sofi1209/TALAVERA-v1-TestBench/hardware/README.md

# Hardware

KiCad projects for the two TALAVERA boards.

| Project | Board | Outline |
|---|---|---|
| `talavera-bench/` | Bench board — mounts on the test stand | 100 × 80 mm **placeholder** |
| `talavera-station/` | Control station board — operator position, 20 m away | 80 × 60 mm **placeholder** |
| `libraries/` | Project symbols, footprints and 3D models | — |

---

## Status: schematics drawn, values incomplete

> Both boards now carry a full schematic. **96 components across the two sheets**, zero structural
> errors. Nothing is approved and no board has been fabricated.
>
> The pyro and analog blocks are complete in **topology** but carry `TBD` values, because `R_TEST1`/`R_TEST2` (Rev A.2),
> the fuse and relay ratings need the e-match no-fire current (O-1), and the PGA gain, excitation
> and reference choice need the load cell datasheet (O-2).
>
> One block is deliberately **not drawn**: the path-2 monitor buffer (O-19). No part is chosen, so
> no circuit was invented for it.

| Board | Components | Nets | Sheet |
|---|---|---|---|
| `talavera-bench` | 54 | 47 | A2, nine labelled blocks |
| `talavera-station` | 42 | 31 | A2, six labelled blocks |

Both are **flat single sheets** with net-label connectivity rather than hierarchical sheets. At this
size that is easier to review than nine sub-sheets, and every block is boxed and titled.

### Generated, not hand-drawn

The `.kicad_sch` files are produced by `tools/gen_bench.py` and `tools/gen_station.py` on top of
`tools/ksch.py`, which reads symbol definitions straight out of the installed KiCad libraries and
flattens `extends` inheritance. Regenerate with:

```bash
cd hardware/tools && python gen_bench.py && python gen_station.py
```

`tools/validate_sch.py` checks structure independently of KiCad — paren balance, that every `lib_id`
resolves, that every instance pin exists in its symbol, duplicate references, off-sheet placement,
orphaned labels and single-use nets:

```bash
python hardware/tools/validate_sch.py hardware/talavera-bench/talavera-bench.kicad_sch hardware/talavera-station/talavera-station.kicad_sch
```

They are ordinary KiCad files and can be edited by hand afterwards; just be aware a regeneration
would overwrite manual edits.

## KiCad version

Targets **KiCad 10.0**. File format versions were read from the demo projects shipped with the installed
KiCad rather than assumed:

| File | Format version | Generator |
|---|---|---|
| `.kicad_sch` | `20250610` | `eeschema` |
| `.kicad_pcb` | `20250513` | `pcbnew` |
| `.kicad_pro` | `meta.version 3` | — |

Opening these in an older KiCad will fail or force a downgrade. If you need an older version, say so
and the projects will be regenerated.

---

## Net classes

Defined up front so that **DRC enforces pyro separation**, rather than relying on a reviewer noticing a
thin trace. Nets are assigned by name pattern, so a correctly named net inherits the right rules
automatically.

| Class | Pattern | Clearance | Track width | Why |
|---|---|---|---|---|
| `PYRO` | `PYRO_*` | 1.00 mm | 2.00 mm | Firing current, and the widest clearance on the board |
| `SAFETY` | `ARM_*`, `FIRE_*`, `ESTOP_*` | 0.50 mm | 0.50 mm | Safety signalling |
| `POWER` | `+12V*`, `+5V*` | 0.40 mm | 1.00 mm | Supply rails |
| `ANALOG` | `LC_*`, `THRUST_*` | 0.30 mm | 0.30 mm | Load cell and thrust signal |
| `Default` | everything else | 0.25 mm | 0.30 mm | — |

**Use these prefixes when naming nets at Gate 2.** A firing net not named `PYRO_*` will silently inherit
`Default` rules, which is exactly the failure this scheme exists to prevent.

---

## Voltage domains

The logger is an **ESP32-WROOM-32D at 3.3 V** (D-028). That has knock-on effects for Gate 2:

| Domain | Parts | Note |
|---|---|---|
| 12 V | Input protection, relay coils, beacon | Battery rail |
| 5 V | AD620 (path B only), 6N137 bench side on the station | **Needed after all:** the AD620's minimum total supply is 4.6 V, so it cannot run on 3.3 V (D-061). `U_5V` is depopulated while running path A. |
| 3.3 V | ESP32, converter, microSD | Keep the converter in the same domain so its digital bus needs no level translation |

Two consequences to carry into the schematic:

1. **The amplifier gain must keep its output inside the converter's input range at 3.3 V** — that is
   V<sub>DD</sub> + 0.3 V, not whatever the PGA setting might suggest. Open item 11. Note this
   constraint **disappears** if an integrated-PGA converter is chosen, since the converter then takes
   the bridge output directly.
2. **microSD is 3.3 V native**, so the level shifters a 5 V Arduino needed are gone. Do not carry over a
   5 V SD breakout module with an onboard regulator and shifters.

---

## Storage — embedded microSD socket

Decision D-037: an **on-board microSD socket**, not a breakout module. One fewer module and one fewer
set of pin headers to vibrate loose, and the lab already has both the parts and a known-good reference.

Porting the topology from IGNIS-v5 `PCB_Project_IGNIS-v5/Storage.SchDoc`. Confirmed present in that
sheet by inspection of the file:

| Element | Note |
|---|---|
| microSD socket | **THD2528-11SD-GF** (LCSC C283232) — resolved from the IGNIS v5 / MAGNIS v1 lists (D-041) |
| Pull-up resistors | Sheet is labelled "Pull UP Resistances"; 10 k values appear in the parameter set |
| Decoupling | 100 nF and 22 µF appear in the sheet's parameters |
| `SD_CS` | Chip select |
| `SD_DETECT` | **Card-present line — carry this over.** It lets the station confirm a card is seated before the test instead of discovering it afterwards. |

> The IGNIS-v5 pin assignment (`SD_MOSI` IO11, `SD_MISO` IO13, `SD_SCK` IO12, `SD_CS` IO42,
> `SD_DETECT` IO41) is for an **ESP32-S3**. TALAVERA uses the original ESP32-WROOM-32D, which numbers
> its pins differently — reuse the circuit, not the pin numbers. See `firmware/README.md` for the
> TALAVERA pin map.

---

## ADC — settled: ADS1220IPWR

**`ADS1220IPWR`** (D-046): 24-bit, **SPI**, 2 kSPS, integrated PGA ×1–128, TSSOP-16, stocked at both
UNIT and LCSC (C48263). It replaces the ADS1115 and removes the I²C bus that both Wirikuta and IGNIS-v5
had trouble with. Reasoning and the rejected candidates are in
[../docs/ADC-TRADE-STUDY.md](../docs/ADC-TRADE-STUDY.md).

The AD620 is **not populated**. Its DIP-8 socket and a four-link network are laid out so either front
end can be fitted: links `R_BYP1`+`R_BYP2` fitted gives the PGA-only chain (default), while
`R_BYP3`+`R_BYP4` plus the chip gives the two-stage chain. Never fit all four — that shorts the
amplifier output to the bridge.

---

## Design rules that layout must satisfy (Gate 4)

1. Keep-out between the logger zone and the entire firing chain.
2. Connectors on the board edge.
3. Pin 1 marked on every connector, on silkscreen, readable after assembly.
4. Keyed, strain-relieved connectors on every external interface.
5. Analog return separated from high-current return; join at a single defined point.
6. Test points on every rail and every safety signal, probe-accessible with the board mounted.
7. Pyro traces routed away from the analog front end, never parallel to it.

---

## Running checks

KiCad is not run by the design assistant. To produce the reports for Gate 5, run these and paste back
the output:

```bash
kicad-cli sch erc --output erc-bench.rpt hardware/talavera-bench/talavera-bench.kicad_sch
```

```bash
kicad-cli pcb drc --output drc-bench.rpt hardware/talavera-bench/talavera-bench.kicad_pcb
```

Both write a plain-text report to the named file. The same two commands apply to `talavera-station`.
