sofi1209/TALAVERA-v1-TestBench/docs/external-audits/AUDIT-B-chatgpt-2026-11-09.md

# TALAVERA v1 schematic audit

9 November 2026 · Bench and operator station · Revision A · GitHub main at `43e980364137857c72099dcaf6f4be3cf3cbf186`

**Disposition — hold schematic release.** The current design has faults that prevent the bench from powering normally, prevent the station from obtaining its documented supply through the harness, and leave the firing output without a return. The interlock and continuity defects would remain after those connectivity issues were addressed. The hardware-only control architecture is worth keeping. The primary measurement path can be simplified and validated separately from the safety and telemetry circuits.

## What was checked

- Reviewed both uploaded schematic PDFs, their KiCad 10.0.5 netlist exports and ERC reports, and the handoff. Cloned GitHub and inspected both committed KiCad schematics, their generators, requirements, safety decisions, fabrication lists, firmware and bring-up plan. The committed PCB files contain outlines without footprints or routing.
- Re-extracted pin connectivity from the committed schematics with the repository extractor pointed at the symbols embedded in each sheet. All non-power-symbol pin groups matched the attachments, including unnamed groups and no-connect pins. Bench **59 components, 76 groups**. Station **41 components, 48 groups**. Re-ran the project validator with the embedded symbols and reproduced **0 errors / 1 warning** on bench and **0 / 0** on station. The stock tool has a Windows symbol path and skips unresolved symbols, so a bare invocation elsewhere can give misleading results.
- The supplied KiCad ERC reports show **1 error / 2 warnings** on bench and **0 / 0** on station. Local KiCad 9.0.2 could not open the committed files, so I could not independently rerun native KiCad 10 ERC. The reported bench findings agree with the connectivity. I enumerated all 16 static ARM/FIRE/E-STOP/plug combinations and several single faults in a software model of ideal relay contacts. That test assumes healthy supplies, omits transients and is independent of the diode error. No board, firmware build, hardware waveform, physical harness or live test was available.
- **Verified** identifies a source, schematic, netlist or model result. **Conditional** identifies a consequence dependent on a stated assumption, physical test, part selection or revised circuit. Component values without verified part-level evidence remain unqualified.

## Findings in priority order

| ID | Severity | Location | Evidence | Why it matters | Recommended fix or closure | Status |
|---|---|---|---|---|---|---|
| B01 | Blocker | Bench `D_RP1`, `gen_bench.py:26–43` | SS24 pin 1 cathode is on `+12V_FUSED`, and pin 2 anode is on `+12V_PROT`. | Normal battery polarity reverse-biases the series device. The logger and K4 supply are downstream. | Correct the polarity in the generator. Verify real package marking and pad mapping. Re-evaluate the selected part's forward drop, current, heating and fault withstand with the approved power architecture. | Verified polarity. Part suitability open. |
| B02 | Blocker | Station `J_12V1`, both `J_UMB1`, `gen_station.py:23–46` | The matched 12-pin umbilical contains no supply conductor. `+12V_STN` is exposed at `J_12V1`, and `PWR_FLAG` asserts power to ERC. `VBAT_SENSE` comes from a divider. | The station cannot power its ARM/FIRE controls, lamps or receiver through the documented cable. USB only powers the isolated side. A hidden extra feed undermines assembly and field diagnosis. | Decide and document one power architecture. Release a keyed connector and harness drawing with supply, returns, branch protection and shield termination. Resolve the disagreement before pin assignment. | Verified absent feed. Supply architecture open. |
| B03 | Blocker | Bench `P1.2`, `K3.12`, `U_CONT1.2`, `gen_bench.py:106–139` | `PYRO_MATCH_N` has exactly those three pins. The optocoupler transistor emitter's ground is across an isolation boundary. K3 NC only shorts the two output terminals together. | There is no intentional DC return from the load to the source even when `PYRO_MATCH_P` is energized. A grounded scope, harness fault or later rework can change the as-drawn circuit. | Review the complete output and return architecture as one safety circuit with the review owner. Validate differential voltage and return paths on a floating inert fixture. Carry B04–B06 into the same review. | Verified open return. |
| B04 | Blocker | Both boards, `R_CONT1`, `U_CONT1`, `D_CONT1`, K3 | Bench part is **PC817**, while the **6N137** belongs to station telemetry. The PC817 input and resistor are across the load. No independent stimulus exists. K3 shorts the input terminals when disarmed. A station sense-wire short to GND lights `CONTINUITY OK`. | The schematic cannot distinguish a connected load from an open load before arming. The handoff's assertion of permanent current through the load is unsupported. Simply providing a return would still leave a voltage detector that could light with the load open when the output is energized. | Define a separately reviewable, hardware-only pre-arm continuity function with explicit open, short and broken-sense behavior. Close it against the exact initiator specification and a fault analysis. Retire the current `CONTINUITY OK` claim. | Verified topology and false-good wire fault. Initiator limits and future circuit open. |
| B05 | Blocker | K4, `ESTOP_LOOP`, K3, `J_ESTOP1` | E-STOP interrupts K4's coil return only. K1/K3 remain commanded by ARM, and K2 remains commanded if FIRE is held. Reset with both held restores source to `PYRO_MATCH_P` when the plug is present. An `ESTOP_LOOP` short to GND or welded K4 NO defeats the stop in the ideal contact model. | The stop removes master feed in the nominal case while leaving the shunt released if ARM remains active. It cannot ensure no automatic restart. A single fault can bypass the master interrupt once the rest of the circuit is closed. Relay release under the flyback clamp has no verified timing. | Specify what E-STOP must de-energize, require deliberate hardware reset and re-arm, and independently verify energy removal, shunt behavior, contact faults and stop latency with an inert fixture. Resolve the single-point stop dependency before release. | Verified connectivity and modeled behavior. Timing and revised safety architecture open. |
| B06 | Blocker | Umbilical pins 1–3, K1/K2/K3, panel controls | One short between `ARM_LINE` and `FIRE_LINE` bypasses the FIRE switch when armed. A stuck FIRE button creates a similar condition on ARM. K1 and K3 follow the same wire without contact feedback. | The two deliberate actions are independent in the schematic's healthy switch sequence only. With source power and the plug present, one common harness fault can assert the output command. The present open return masks delivery of load current. | Define the harness and interlock fault model, including adjacent-conductor shorts, open returns, partial connection and held controls. Verify it with the protected output disabled or with an authorized inert fixture. Keep ARM, FIRE and E-STOP hardware-only. | Verified fault path. Physical fault behavior and closure open. |
| B07 | Blocker | O-1/O-3/O-17, F1/F2, K1–K4, J_ARM1/P1, `SAFETY.md` | The exact initiator limits, installed contact and terminal ratings, fuse selections, wiring limits and pad mappings remain open. The README contains an older current-budget example for a different cable architecture. | There is no basis to qualify protection, energy limits, contact life or fuse coordination. A shunt fault, supply dip or logger short can interact with shared upstream protection and grounds. | Record exact manufacturer part numbers and review evidence. Reconcile the fault-current and protection review with the actual harness and hardware. Demonstrate that a logger fault cannot defeat the safety functions or invalidate the claimed data retention. | Verified omissions. Margins and outcomes open. |
| B08 | Blocker | Bench `U_3V3`, station `U_5VB1`/`U_3V3B1`, DNP `U_5V1` | Bench input has C2, 22 µF. `+3V3_LOGGER` has nominal 20 µF plus four 100 nF parts spread across loads, with no specified local regulator compensation capacitor/ESR. Station has zero caps on all three bench-referenced rails. `+5V_AMP` has no output cap. The reference AMS1117 data sheet uses output capacitance as compensation. | Startup, ripple and load-transient response are unqualified. The bench 12 V-to-3.3 V drop can exceed the thermal budget. Station cascade has limited dropout margin. A 12 V SLA system needs margin to the regulator's maximum input under charging and transients. | Select exact regulators. For the bench, use a serviceable buck stage for digital power and a separately filtered analog supply if measurements require it. Budget input/output effective capacitance, ESR, quiescent current, load steps, temperature, charging voltage and startup. If keeping the station cascade, prove regulation at minimum rail and worst cable drop. | Verified cap topology. Thermal calculation below uses assumptions. See [AMS1117 data sheet](https://www.datasheets.com/advanced-monolithic-systems/ams1117/datasheet.pdf). |
| M01 | Major | Bench MCU1 / DevKitC headers, `ESP_EN`, `+3V3_LOGGER` | All intended active GPIOs match the bare-module pin functions in the export, but the real DevKitC header numbers and power pins differ. The bare-module GND pad set includes pad 39. Espressif specifies mutually exclusive USB, 5 V header and 3.3 V header power inputs. | Mapping by matching numbers can miswire a replacement module. Programming over USB while the carrier drives 3.3 V can tie supplies together. An unpowered peripheral can be backfed through I/O. | Draw the two actual headers, verify an exact WROOM-based module variant and orientation, and define a mutually exclusive service/programming power mode. Add an accessible rail disconnect and review the on-module EN network. | Verified symbol mismatch. Backfeed behavior needs hardware testing. [Espressif DevKitC guide](https://docs.espressif.com/projects/esp-dev-kits/en/latest/esp32/esp32-devkitc/user_guide.html). |
| M02 | Major | Station `U_ISO1/R_ISO1`, both `U_485`, `logger.ino` | The enabled 6N137 inverts. SP3485 RO sources current through 220 Ω into its LED, but RO's guaranteed high level is specified at 1.5 mA sourcing. The cited 6N137 threshold can be 5 mA. There is no dedicated bypass at the opto, no explicit fail-safe bias for the terminated idle pair, and no bench DE reset bias. Firmware has no RS-485 TX/DE implementation. | Ordinary high UART idle becomes low at CH340C RX unless polarity is corrected. The handoff's LED-current estimate assumes an ideal 3.3 V source. Reset and missing-transmitter states can corrupt reception. Optional reverse path is DNP and fitting it alone cannot enable a driver strapped off. | Use a buffered or inherently compatible, receive-only isolated interface with correct end-to-end polarity, local bypass and a defined idle/reset state. Verify with a known pattern at both UARTs, absent cable and independent USB/bench power sequences. Remove the optional reverse path from the default build documentation. | Verified topology and firmware omission. Margin and idle behavior conditional. [SP3485](https://www.maxlinear.com/ds/sp3485.pdf), [Vishay 6N137](https://www.vishay.com/docs/84732/6n137.pdf), [Lite-On 6N137](https://www.mouser.com/datasheet/2/813/6N137_Series-1516684.pdf). |
| M03 | Major | J_UMB1 pins 10–12, J_DAQ1.3, USB and exposed I/O | Shield-designated pin 12 is on GND at both boards. Station `GND` and `GNDREF` are separate in the netlist. J_DAQ exports bench GND. The USB data TVS pair is the only explicit external-line clamp protection shown. | Harness and enclosure bonds can defeat a single-point shield plan. A grounded DAQ used alongside the same laptop can bridge the isolation barrier externally. Cable faults or ESD can affect controls and telemetry. | Publish a complete shield, chassis and return diagram with external equipment connected. Keep the USB ground separation through layout and verify it in the installed setup. Choose protection for exposed lines with a failure-mode review, especially devices that could short the E-STOP return. | Verified connectivity. Installed grounding and surge performance open. |
| M04 | Major | Station `LS1/Q_BUZZ1` and hardware indications | Huaneng MLT-8530 is a low-voltage passive transducer characterized with an AC square wave. It is switched from nominal 12 V DC. Station ARM indicates the command line, bench ARM indicates `ARM_BUS`, and FIRE indicates `PYRO_FIRE_OUT` upstream of the plug. | Audible warning can fail or overheat. The lamps cannot establish plug insertion, a released shunt, load current, or safe state when dark. | Use a replaceable panel sounder rated for the actual DC rail. Label command and actual state separately, and verify any indication claimed as an interlock using actual hardware feedback. | Verified wiring and buzzer mismatch. [Huaneng data sheet](https://datasheet.lcsc.com/lcsc/1811182003_Jiangsu-Huaneng-Elec-MLT-8530_C94599.pdf). |
| M05 | Major | Bench U_ADC1, J_LC1, R_EXC_P1/N1, ADC inputs | Default path selects AIN0/AIN1 and physically references REFP0/REFN0 to board-side bridge excitation. Bridge, ADC and digital loads share 3.3 V. No analog input filter or fault protection is drawn. | Ratiometric conversion can reject slow excitation changes common to signal and reference. It cannot cancel lead drops outside the reference sense points, supply/return disturbances, unequal filtering or ADC saturation. | Freeze O-2. Validate the sensor's wiring, bridge resistance, mV/V, excitation, zero offset, overload and required bandwidth. Check PGA common mode and full-scale analytically. Add separate close AVDD/DVDD bypass, balanced input filtering and connector-side protection as required. Verify zero, span and noise with a bridge simulator and actual sensor. | Verified wiring, conditionally sound topology. [TI ADS1220 data sheet](https://www.ti.com/lit/ds/symlink/ads1220.pdf). |
| M06 | Major | Bench DNP `U_AMP1`, `AMP_REF`, `R_BYP1–4` | `AMP_REF` connects only to AD620 REF and the DNP ADC negative link. It has no low-impedance bias source. The optional 5 V regulator has no output cap. All four links fitted tie the amplifier outputs/reference network onto bridge signal nodes. | Path B cannot be validated from the shown wiring. A nominal 5 V supply alone does not establish input common mode, output swing or compatibility with the 3.3 V ADC. The population options add avoidable assembly errors. | For a maintainable Rev A, keep the direct ADS1220 path and remove the unqualified alternative from the standard assembly. If needed, qualify Path B separately with reference drive, headroom and mutually exclusive population. | Verified absent bias and caps. Headroom conditional. [Analog Devices AD620](https://www.analog.com/en/products/AD620.html). |
| M07 | Major | `logger.ino:96–112, 139–161, 219–255`, CARD1 | Register placeholders select gain 1 and 20 SPS normal continuous mode. The trade study targets at least 1 kSPS. Firmware prints placeholder scaled counts as `thrust_N`, uses synchronous CSV writes and flush, has no sequence counter and relies on polling DRDY. SD init failure leaves the logger inactive until reset. ADC CS has no hardware pull-up. SD connector detect pad numbering disagrees with the schematic note and BOM. | The logger can miss the transient or drop conversions silently. A card or power problem can appear as a recorded or calibrated test when it was neither. | Establish raw-only behavior until calibration. Log config, timestamps, sample sequence and dropped counts. Verify sustained capture through SD stalls, interrupted power and restart. Define a distinct fault indicator, hardware CS defaults and local card decoupling. Bench-check the actual connector detect switch and retention. | Verified code and pin discrepancy. Detect mechanism, losses and throughput open. [TI ADS1220](https://www.ti.com/lit/ds/symlink/ads1220.pdf), [LCSC socket listing](https://www.lcsc.com/product-detail/C283232.html). |
| M08 | Major | Both `THRUST_DIFF_*` lines, J_DAQ1, O-19 | Bench ends at J_UMB pins 8/9. Station carries the same pins to J_DAQ. The bench note explicitly omits the buffer. | The advertised analog backup cannot produce a signal. The circuit can be present at both connectors and still have no source. | Either implement and independently validate the required measurement path, or defer it explicitly in the requirements and mark the pins reserved. Record the loss of redundancy in Rev A. | Verified. |
| M09 | Major | `R_V1/R_V2`, `VBAT_SENSE`, J_VM1 | Divider reads `+12V_PROT`, after D_RP. Ratio is 10/57. No meter model or independent meter supply is drawn. | A generic voltmeter cannot be assumed to scale or power correctly. Cable return drop and input loading alter the reading. | Select a high-impedance readout with a verified scale and supply. Decide whether the requirement refers to battery terminal voltage or protected-rail voltage and label it accordingly. | Verified ratio and missing meter spec. Measurement error conditional. |
| M10 | Major | Both sheets, fabrication CSVs, generator and release checks | No test-point symbols are present in the exports. BOM still lists the deleted continuity switch and obsolete umbilical pyro pair. The relays have generic IEC pin identifiers, Q_BUZZ uses letter pins, and USB/microSD require exact physical pad maps. Generators hard-code local Windows paths. | A board can pass ERC and still be assembled from a stale BOM or built with swapped contacts. Fault isolation and module replacement become slow. | Make generator output paths portable. Generate a revision-locked BOM and harness from the reviewed schematic, fail checks on missing libraries, and validate the symbol-to-footprint map against each actual part. Add accessible, labeled service points and removable branch links. | Verified source and BOM. Physical pad maps unverified. |
| M11 | Major | `SAFETY.md §7`, README, D-007/D-011 | Repository estimates 15–17 m actual separation with its 20 m harness, below its own cited minimum. NAR S&T manual §8.3.5 ties open-ground static testing to launch-code separation and allows reduction when protected by a substantial barrier at the supervisor's judgment. | An internal deviation entry does not qualify separation for the site. Harness length and cable loss affect station operation and the fault review. | Resolve actual site, motor class, barrier, governing requirements and usable separation with the review owner before finalizing harness requirements. | Verified repo inconsistency and NAR language. Applicability in Mexico requires site-specific determination. [NAR S&T testing manual](https://thisistheoldsite.nar.org/wp-content/uploads/2014/08/ST-MotorTestingManual.pdf). |
| N01 | Minor | Station USB data and CC pins | Independent 5.1 kΩ CC pull-downs and paired D+/D− orientation pins are coherent. WCH's reference application should govern the final data-series arrangement. USB-C symbol-to-part map and local enclosure shielding are open. | A connection that enumerates in one orientation or one host can still be mechanically or electrically fragile. | Confirm the exact connector drawing, both plug orientations, enumeration with realistic cables, and a footprint that can be replaced without stripping pads. | Verified netlist. Hardware unverified. [WCH CH340 data sheet](https://datasheet.lcsc.com/lcsc/2304140030_WCH-Jiangsu-Qin-Heng-CH340C_C84681.pdf). |

## Polarity and contact sweep

- **Series Schottky** — D_RP1 is reversed. K is on `+12V_FUSED` and A on `+12V_PROT`.
- **Bench flybacks** — D_K1 and D_K3 are K to `ARM_LINE`, A to GND. D_K2 is K to `FIRE_LINE`, A to GND. D_K4 is K to `+12V_PROT`, A to `ESTOP_LOOP`. Each diode is reverse-biased while its coil is normally energized. Verify physical polarity and contact-release timing with the suppression circuit fitted.
- **Station flyback** — D_BUZZ1 is K to `+12V_STN`, A to `BUZZ_DRV`. This orientation is consistent with a low-side inductive load. The specified sounder and drive are separately incorrect. The Q_BUZZ divider computes 4.86 V at a 12 V ARM line versus the onsemi device's ±20 V absolute gate rating. Match symbol G/S/D to physical pads 1/2/3. [onsemi NTS4001N](https://www.onsemi.com/download/data-sheet/pdf/nts4001n-d.pdf).
- **LEDs** — Bench D_ARM1, D_FIRE1, D_PWR1 and D_LOG1 have cathodes on GND and resistor-fed anodes. Station D_ARMED1 and D_PWR1 follow the same pattern. D_CONT1 has its anode fed through a resistor from `+12V_STN` and cathode on the PC817 collector signal. The lamp polarity is correct for active-low signaling. Its meaning is wrong because the input circuit does not measure continuity.
- **Optocouplers** — PC817 uses pins 1/2 for LED A/K, 3 for emitter to GND and 4 for the sense collector. Both 6N137 symbols use LED A/K on 2/3 and output-side GND/OUT/EN/VCC on 5/6/7/8. Their LEDs have the intended polarity. Active inversion and drive current remain issues. [Vishay 6N137](https://www.vishay.com/docs/84732/6n137.pdf).
- **TVS and capacitors** — D_ESD1/2 are bidirectional ESD9B5.0ST5G between USB D+/D− and GNDREF, so there is no diode orientation error. The two SOD-923 packages are difficult to replace by hand. All 11 capacitor symbols across both boards are generic, unpolarized `Device:C`. Bench C1/C2 each show pin 1 on the positive rail and pin 2 on ground. Any polarized implementation needs an exact MPN, polarized symbol and verified footprint. [onsemi ESD9B](https://www.onsemi.com/download/data-sheet/pdf/esd9b-d.pdf).
- **Relay rest states** — K1, K2 and K4 use COM 11 and NO 14. K3 uses COM 11 and NC 12. Ideal de-energized contacts open the three series paths and close the shunt. This verifies the drawing's contact selection. Exact Songle physical pin mapping, bounce, pickup/dropout, welds and recovery remain open. [Songle SRD listing](https://www.lcsc.com/product-detail/Relays_SRD-12VDC-SL-C_C30431.html).

## Power and measurement checks

**Rail chain.** On the bench, `+12V_RAW → F1 → +12V_FUSED → D_RP1 → +12V_PROT`. K4 switches `+12V_MASTER`, while F2 separately feeds `+12V_LOGGER` upstream of K4. `+3V3_LOGGER` runs the DevKitC, ADS1220, SD, SP3485 and bridge. The DNP `+5V_AMP` serves only the DNP amplifier. On the station, `J_12V1 → +12V_STN → U_5VB1 → +5V_BENCH → U_3V3B1 → +3V3_BENCH`. The fitted station optocoupler output and USB-UART are fed by `+5V_USB`, independently of the station's bench-side supply. Add the bench logger-rail PWR_FLAG only after documenting the actual source through F2. The station PWR_FLAG cannot supply an omitted harness feed.

**Budget.** For the handoff's assumed 12.0 V at regulator input and 150 mA, bench regulator dissipation is about `(12.0 − 3.3) × 0.15 = 1.305 W`, excluding regulator ground current. At assumed 55 °C ambient and 60 °C/W, the estimate is 133 °C. Actual copper, enclosure and current are unknown. A 12→5→3.3 linear cascade at the same current splits the same heat into about 1.05 W and 0.255 W. It reduces the second stage's heating but leaves the first stage dissipating about 1 W. The cited AMS1117 test range for the 3.3 V fixed part begins at 4.75 V. A nominal 5 V upstream rail therefore leaves about 0.25 V to that point before tolerance, ripple and wiring loss. Budget average and peak currents separately. Include DevKitC startup, SD writes, bus loading, bridge current `V_EXC/R_bridge`, indicators, relay coil pickup, cable drops and all normal power combinations. At nominal coil voltage the 400 Ω Songle coil is about 30 mA, or 120 mA for four coils supplied across the two domains, excluding all other loads. These values do not constitute a complete supply or fault budget. [AMS1117 data sheet](https://www.datasheets.com/advanced-monolithic-systems/ams1117/datasheet.pdf), [Songle SRD listing](https://www.lcsc.com/product-detail/Relays_SRD-12VDC-SL-C_C30431.html).

**Battery readback.** With an unloaded divider and 12 V at `+12V_PROT`, expected `VBAT_SENSE` is 2.105 V. The divider output impedance is approximately 8.25 kΩ. Include meter input loading, offset and ground difference in the calibration. A threshold specified at the battery terminals cannot be transferred uncorrected to a post-diode measurement.

**ADC.** With `AVDD = 3.3 V` and `AVSS = 0 V`, the enabled PGA's common mode must satisfy both `VCM ≥ max(0.825 V, 0.2 V + G·|VIN|max/2)` and `VCM ≤ 3.1 V − G·|VIN|max/2`, in addition to the differential full-scale limit set by reference voltage and gain. A balanced bridge near mid-excitation is plausible. The actual load cell can only be qualified with its offset, span, excitation and overload data. The proposed external reference is physically connected to board-side excitation, so cable drops to a four-wire bridge are outside the sense points. The placeholder 20 SPS yields a 50 ms sample interval, longer than the repository's assumed 10–30 ms rise. [TI ADS1220 data sheet](https://www.ti.com/lit/ds/symlink/ads1220.pdf).

## Changes that make this bench easier to repair

1. **Partition it by fault domain.** Give the mechanical control/output circuit, logger/analog rail and station telemetry independently identifiable connectors, protection and accessible disconnects. Preserve the logger's upstream supply intent. A dead logger, SD card, USB interface or optional monitor should be diagnosable without disturbing the hardware interlocks.
2. **Make state and power visible.** Provide labeled probe points with adjacent return points for raw/fused/protected power, master, logger and analog rails, station supply, isolated USB supply, control lines, and the two ADC inputs and reference pins. Keep sensitive output test access recessed or shrouded. Put meter-friendly pin numbers and polarity on both mating drawings and the silkscreen. Document expected voltage and continuity for each troubleshooting state.
3. **Prioritize easy replacement.** Use keyed, locking, mechanically supported harness connectors, replaceable fuse holders, and clearance to extract the DevKitC and service the SD card without removing the board. Use larger hand-rework packages where space permits, especially at external connectors. Prefer a simple authorized population drawing over multiple overlapping DNP options. Validate connector, relay, fuse, USB, MOSFET and SD footprints with actual parts before layout release.
4. **Give each test a pass condition.** First re-export with the same KiCad version, require zero native ERC errors, disposition each warning and compare exports with committed sources. Add assertions for diode polarity, both endpoints of each intended conductor, rail source reachability, safety contact state and isolation boundaries. Then, under the project's written authorization, use a current-limited bench supply and inert fixtures for power sequencing, control-fault behavior, capture throughput, and full-harness USB/DAQ isolation. Measure rails and stop latency. Verify saved files after brownouts and abrupt interruption, and run a calibrated bridge-input test before relying on thrust data.

**Safety finding.** The schematic gives the MCU no direct path to drive a relay coil or the firing output. Its RS-485 signals share the same field harness and the logger shares supply and ground infrastructure. A proof that a single logger fault cannot energize the output requires analysis of the installed wiring, rail faults, clamp faults, contact faults and cross-shorts. The contact model and ERC do not establish that property. This audit gives no hardware or live-test sign-off.

## Project references

- [Pinned GitHub revision](https://github.com/sofi1209/TALAVERA-v1-TestBench/tree/43e980364137857c72099dcaf6f4be3cf3cbf186)
- [Bench generator](https://github.com/sofi1209/TALAVERA-v1-TestBench/blob/43e980364137857c72099dcaf6f4be3cf3cbf186/hardware/tools/gen_bench.py) · [Station generator](https://github.com/sofi1209/TALAVERA-v1-TestBench/blob/43e980364137857c72099dcaf6f4be3cf3cbf186/hardware/tools/gen_station.py)
- [Requirements](https://github.com/sofi1209/TALAVERA-v1-TestBench/blob/43e980364137857c72099dcaf6f4be3cf3cbf186/docs/REQUIREMENTS.md) · [Safety](https://github.com/sofi1209/TALAVERA-v1-TestBench/blob/43e980364137857c72099dcaf6f4be3cf3cbf186/docs/SAFETY.md) · [Bring-up plan](https://github.com/sofi1209/TALAVERA-v1-TestBench/blob/43e980364137857c72099dcaf6f4be3cf3cbf186/test/BRINGUP-PLAN.md)
- [Logger source](https://github.com/sofi1209/TALAVERA-v1-TestBench/blob/43e980364137857c72099dcaf6f4be3cf3cbf186/firmware/logger/src/logger.ino)
