sofi1209/TALAVERA-v1-TestBench/fabrication/PARTS-LIST.md

# TALAVERA v1 — Preliminary parts list

> ### PRELIMINARY — not a BOM
>
> **No schematic exists.** Gate 2 has not started, so there is no netlist to reconcile against.
> Designators are placeholders, quantities are estimates, and rows marked `[CANDIDATE]` carry
> **unverified** part numbers. The IGNIS v5 and MAGNIS v1 lists state that their designators and
> quantities match a netlist; **this list cannot make that claim yet.**
>
> Do not order from this document. It exists so lab stock can be checked early.

> ### Assembly constraint (D-049)
>
> The board goes to **JLCPCB assembled**, so every *populated* part must be **LCSC-stocked**.
> This is what ruled out a populated AD620: the SOIC `AD620ARZ` is listed under LCSC
> “Pre-ordered Products”, which JLCPCB very likely cannot place. Panel controls, the DevKitC
> and the AD620 bypass option are hand-fitted and exempt.

Formatted to match `IGNIS_V5_Parts_List_rev3.xlsx` and `MAGNIS_v1_Parts_List.xlsx`.
LCSC codes are reused from those lists where the part is the same.

Spreadsheet versions: [`TALAVERA_v1_Parts_List_bench.csv`](TALAVERA_v1_Parts_List_bench.csv) · [`TALAVERA_v1_Parts_List_station.csv`](TALAVERA_v1_Parts_List_station.csv) — open directly in Excel.

**Status values:** `In lab` = confirmed present in the IGNIS v5 / MAGNIS v1 lists · `Pending decision` = awaiting a gate decision · `TBD` = not yet specified · `Candidate` = proposed, unverified

| | Lines |
|---|---|
| Confirmed in lab | **30** |
| Still TBD or pending | **23** |

---

## Bench board

### LOGGER

| Status | Component name | ID # (part number) | Designator | Amount | LCSC | UNIT Electronics | Mouser MX | DigiKey MX | Notes |
|---|---|---|---|---|---|---|---|---|---|
| In lab | Dev board ESP32-DevKitC V4 (WROOM-32D, PCB antenna) | ESP32-DevKitC-32D | MCU1 | 1 | -- | UNIT | Mouser | DigiKey | Socketed, as on MAGNIS v1. Radios stopped in firmware (D-029). Choose the 32D option at UNIT. |
| In lab | Female header 1x19, 2.54 mm | PPTC191LFBN-RC | - (MCU1) | 2 | -- | UNIT | Mouser | DigiKey | Sockets for the DevKit. Cut from a 1x40 strip. Same approach as MAGNIS v1. |

### STORAGE

| Status | Component name | ID # (part number) | Designator | Amount | LCSC | UNIT Electronics | Mouser MX | DigiKey MX | Notes |
|---|---|---|---|---|---|---|---|---|---|
| In lab | MicroSD socket push-push | THD2528-11SD-GF | CARD1 | 1 | C283232 | UNIT | Mouser | DigiKey | Pin 9 CD -> SD_DETECT with a 10 k pull-UP (as IGNIS v5 R28). Locating pegs drilled 1.3 mm (MAGNIS v1). Shell pads MP1-4 to GND. |

### ANALOG FRONT END  (D-046)

| Status | Component name | ID # (part number) | Designator | Amount | LCSC | UNIT Electronics | Mouser MX | DigiKey MX | Notes |
|---|---|---|---|---|---|---|---|---|---|
| New (approved) | 24-bit ADC, SPI, 2 kSPS, integrated PGA x1-128, TSSOP-16 | ADS1220IPWR | U_ADC | 1 | C48263 | UNIT | Mouser | DigiKey | SELECTED. Replaces the ADS1115 and its I2C bus. Stocked at BOTH UNIT and LCSC (C48263, ~15.9k, ~$1.71 @100) - stock checked 6 Nov 2026, re-verify before ordering. Internal PGA is the PRIMARY front end. Verify input common-mode range with PGA enabled at 3.3 V against the load cell (open item 4). |
| Optional / socketed | Instrumentation amplifier, DIP-8 (optional) | AD620AN | U_AMP | 0 (socket fitted) | -- | UNIT | Mouser | DigiKey | DIP-8 in a SOCKET, not populated by default (D-054). UNIT stocks the through-hole part at ~111 MXN. A socket makes the A/B comparison a chip pull, not a rework. Left out by default: at ~$6-8 it is the most expensive part on the board and the ADS1220 PGA makes it redundant. |
| New (approved) | IC socket DIP-8 | Generic DIP-8 socket | XU_AMP | 1 | -- | UNIT | Mouser | DigiKey | Always fitted, so the AD620 can be added or removed without soldering. |
| New (approved) | Resistor 0 ohm 0805 - AD620 bypass links | Generic 0 R jumper | R_BYP1, R_BYP2 | 2 | -- | UNIT | Mouser | DigiKey | Fitted = PGA-only chain (default). Removed + AD620 in its socket = two-stage chain. Lets both be measured on identical hardware in bring-up Stage 4. |
| TBD | Load cell excitation reference | TBD | U_REF | 1 | -- | -- | -- | -- | Cannot be specified until the load cell datasheet is available (open item 4). Check whether the excitation can serve as the ADS1220 external reference for a ratiometric measurement, which would cancel excitation drift. |

### SAFETY CHAIN  (hardware only - no MCU)

| Status | Component name | ID # (part number) | Designator | Amount | LCSC | UNIT Electronics | Mouser MX | DigiKey MX | Notes |
|---|---|---|---|---|---|---|---|---|---|
| New (approved) | Relay SPDT, 12 V coil, 10 A contacts, through-hole | SRD-12VDC-SL-C | K1, K2, K3, K4 | 4 | C30431 | -- | Mouser | DigiKey | ONE part for all four positions (D-055). K1/K2/K4 wired NO; K3 uses BOTH contacts of its pole - NC is the shunt, NO the low-side return (D-065) - and its coil follows the FIRE command, not ARM (Batch 2, pending sign-off). K1's NC is the continuity TEST source. ~$0.23, ~131,800 in LCSC stock. The datasheet in hand is Sanyou-branded SRD V3.2 while the part is listed as Songle - provenance OPEN. Per that datasheet: 10 A NO / 6 A NC at 28 VDC, pick-up <= 9 V, release guaranteed only <= 0.6 V. Break-before-make NOT stated (O-3): measure on real units. CONTACT MARGIN still blocked on O-1. |
| TBD | Arming plug / removable shorting link | TBD | J_ARM | 1 | -- | -- | -- | -- | Withdrawn by hand at the bench, inserted last. Must be keyed and obviously absent at a glance. |
| In lab | Switching diode - relay coil flyback | 1N4148W | D_K1..D_K4 | 4 | C81598 | UNIT | Mouser | DigiKey | One per relay coil. D_K2 and D_K3 sit across the FLOATING FIRE-loop coils (cathode on A1). |
| Pending decision | Switching diode - K3 coil OR and TEST blocking | 1N4148W | D_K3F, D_K3T, D_CBLK | 3 | C81598 | UNIT | Mouser | DigiKey | Batch 2, pending sign-off. D_K3F/D_K3T OR the FIRE and TEST commands into the K3 coil (~30 mA); D_CBLK keeps the 12 V on MATCH_P during FIRE off the opto LED. 1N4148W ratings to confirm against its datasheet (not in the repo). |

### PYRO INTERFACE  (one channel - D-015)

| Status | Component name | ID # (part number) | Designator | Amount | LCSC | UNIT Electronics | Mouser MX | DigiKey MX | Notes |
|---|---|---|---|---|---|---|---|---|---|
| In lab | Optocoupler SMD-4, CTR 100-600 % | TLP521GB-S (UMW) | U_CONT | 1 | C364143 | UNIT | Mouser | DigiKey | Continuity TEST current detector (Batch 2): its LED is IN SERIES with the test current and its transistor SOURCES the active-high sense line. The schematic value reads PC817 - reconcile with this line (P-22). CTR at the very low test current O-1 will allow is UNVERIFIED and may force a different detector. |
| In lab | Screw terminal 6-pin 5.08 mm | 1729160 | P1 | 1 | C457192 | -- | Mouser | DigiKey | E-match pair plus umbilical pyro pair. Not at UNIT (KF301 is 5.0 mm pitch). |
| Candidate | N-MOSFET 60 V / 5 A (SOT-223) | NCE6005AR | Q_FIRE | 1 | C189606 | UNIT | Mouser | DigiKey | ONLY if a solid-state firing element is chosen downstream of the relays. Relays remain the primary interrupt. |
| TBD | Continuity TEST series resistors - TWO in series | TBD | R_TEST1, R_TEST2 | 2 | -- | -- | Mouser | DigiKey | Batch 2. EACH resistor ALONE must hold the test current below the e-match no-fire rating, so one short-failed resistor cannot fire the match. Cannot be computed - O-1. Replaces R_CONT, which sat in parallel with the match with no source. |
| TBD | Continuity sense source resistor | TBD | R_CS | 1 | -- | -- | Mouser | DigiKey | Sets the sense-line current into the station CONTINUITY lamp. Depends on the detector CTR at the O-1 test current. |

### INDICATORS

| Status | Component name | ID # (part number) | Designator | Amount | LCSC | UNIT Electronics | Mouser MX | DigiKey MX | Notes |
|---|---|---|---|---|---|---|---|---|---|
| In lab | Red LED 0805 | NCD0805R1 | D_IND1..6 | 6 | C84256 | UNIT | Mouser | DigiKey | Hardware-driven status LEDs. |
| TBD | High-brightness beacon LEDs, long-range | TBD | D_BEACON | TBD | -- | -- | Mouser | DigiKey | Must be visible at 20-40 m (manual p. 24). DRIVEN FROM THE REAL ARM/FIRE LINES (D-017), not from the MCU. |
| Logger status only | Addressable RGB LED 5050 | WS2812B-B/T | LED1 | 1 | C2761795 | UNIT | Mouser | DigiKey | CAUTION: addressable LEDs need an MCU data signal, so they CANNOT serve the safety beacon (D-017). Logger-local status only. |

### TELEMETRY  (secondary path - BUILT IN REV A, D-048)

| Status | Component name | ID # (part number) | Designator | Amount | LCSC | UNIT Electronics | Mouser MX | DigiKey MX | Notes |
|---|---|---|---|---|---|---|---|---|---|
| New (approved) | RS-485 transceiver, 3.3 V, half-duplex | SP3485EN-L/TR | U_485 | 1 | C8963 | -- | Mouser | DigiKey | Native to the ESP32 3.3 V domain. ~$0.14-0.27, ~190,700 in LCSC stock. Replaces the ~$10 ADM2582E (D-056): isolation moves to the STATION board where USB powers the isolated side, so no isolated DC-DC is needed anywhere. |

### POWER & PROTECTION

| Status | Component name | ID # (part number) | Designator | Amount | LCSC | UNIT Electronics | Mouser MX | DigiKey MX | Notes |
|---|---|---|---|---|---|---|---|---|---|
| TBD | Reverse-polarity CROWBAR diode | TBD | D_XBAR | 1 | -- | -- | Mouser | DigiKey | Batch 2 (P-05), pending sign-off: replaces the series SS24 D_RP, a 2 A-class part that sat in the 6-12 A fire path. Anode GND, cathode +12V_PROT after F1. Must survive F1's clearing I2t at the battery's short-circuit current - both unknown (O-17; SLA maker and Isc not recorded). |
| TBD | Battery connector, KEYED | TBD | J_PWR | 1 | -- | -- | Mouser | DigiKey | Batch 2: keying makes reversal mechanically unlikely; the crowbar is the backstop, not the plan. |
| In lab | LDO 3.3 V | AMS1117-3.3 | U_3V3 | 1 | C6186 | UNIT | Mouser | DigiKey | Logger domain. Own fused rail, separate from relay coils (SAFETY.md section 4, constraint 3). |
| In lab | LDO 5 V | AMS1117-5.0 | U_5V | 1 | C6187 | UNIT | Mouser | DigiKey | Only if a 5 V rail proves necessary. Confirm at Gate 2. |
| TBD | Fuse and holder, 12 V input | TBD | F1 | 1 | -- | -- | Mouser | DigiKey | Rating pending the current budget. Separate fuse for the logger rail. |
| TBD | TVS / ESD array - one per umbilical conductor | TBD | D_TVS | 10-12 | -- | -- | Mouser | DigiKey | ESD protection on all external connectors is a Gate 2 requirement. |

### CONNECTORS & TEST

| Status | Component name | ID # (part number) | Designator | Amount | LCSC | UNIT Electronics | Mouser MX | DigiKey MX | Notes |
|---|---|---|---|---|---|---|---|---|---|
| In lab | JST-SH 4-pin right-angle (debug UART) | SM04B-SRSS-TB(LF)(SN) | J_DBG | 1 | C160404 | UNIT | Mouser | DigiKey | Logger debug only. Not a safety interface. |
| TBD | Umbilical connector, keyed + strain relief | TBD | J_UMB | 1 | -- | -- | Mouser | DigiKey | Cable B, 12 conductors; pin map in hardware/tools/umbilical.py (Batch 2, pending sign-off). FIRE_P/FIRE_N must be a twisted pair. Adjacency is assumed linear with 12 next to 1 - re-run the short matrix against the real connector rows and cable lay-up. Keyed, strain-relieved, pin 1 marked. |
| New (approved) | Test point - bare pad / via | Bare pad (no part) | TP1..TP14 | ~14 | -- | -- | -- | -- | Test points on EVERY rail and EVERY safety signal (Gate 2 requirement). Bare pads replace Keystone 5015 (D-057): free, and they work with probe hooks. |

### PASSIVES  (existing IGNIS library - 0603 R, 0805 C, D-058)

| Status | Component name | ID # (part number) | Designator | Amount | LCSC | UNIT Electronics | Mouser MX | DigiKey MX | Notes |
|---|---|---|---|---|---|---|---|---|---|
| In lab | Resistor 10 kOhm 0603 1 % | 0603WAF1002T5E | R* | ~12 | C25804 | UNIT | Mouser | DigiKey | Pull-ups, dividers, SD_DETECT. 0603 retained (D-058): reels already owned, and hand-solderable. |
| In lab | Resistor 4.7 kOhm 0603 1 % | 0603WAF4701T5E | R* | ~4 | C23162 | UNIT | Mouser | DigiKey |  |
| In lab | Resistor 1 kOhm 0603 1 % | 0603WAF1001T5E | R* | ~8 | C21190 | UNIT | Mouser | DigiKey | LED series, opto drive |
| In lab | Resistor 100 Ohm 0603 1 % | 0603WAF1000T5E | R* | ~4 | C22775 | UNIT | Mouser | DigiKey |  |
| In lab | Capacitor 100 nF 50 V X7R 0805 | CC0805KRX7R9BB104 | C* | ~15 | C49678 | UNIT | Mouser | DigiKey | Decoupling |
| In lab | Capacitor 10 uF 25 V X5R 0805 | CL21A106KAYNNNE | C* | ~6 | C15850 | UNIT | Mouser | DigiKey |  |
| In lab | Capacitor 22 uF 25 V X5R 0805 | CL21A226MAQNNNE | C* | ~3 | C45783 | UNIT | Mouser | DigiKey | Bulk on the logger rail |
| New (approved) | Resistor 0 ohm 0805 - PYRO_RTN star bond | Generic 0 R jumper | R_STAR | 1 | -- | UNIT | Mouser | DigiKey | Single bond between the firing-current return and board ground, at the J_PWR star point. Rev A.1, audit finding R-1: without a separate PYRO_RTN the fire current (~6-12 A pending O-1) returns through the same net as the load-cell excitation return and the ADS1220 AVSS, during the burn. 0805 is a placeholder - size the link and its copper for the fire current once O-1 lands, and consider a solid wire link or a bolted star post instead. |

---

## Control station board

### CONTROLS  (hardware only - no MCU in the safety chain)

| Status | Component name | ID # (part number) | Designator | Amount | LCSC | UNIT Electronics | Mouser MX | DigiKey MX | Notes |
|---|---|---|---|---|---|---|---|---|---|
| TBD | ARM key switch, removable key, 2-position, THREE poles | TBD | S_ARM | 1 | -- | -- | Mouser | DigiKey | Batch 2: pole 1 changeover (ON feeds ARM, OFF feeds TEST); poles 2 and 3 closed in OFF only (FIRE_N to ground for TEST; RESET enable). Key removable, carried by the ignition officer. |
| TBD | E-STOP, mushroom head, latching, TWO positive-opening NC blocks | TBD | S_ESTOP | 1 | -- | -- | Mouser | DigiKey | Batch 2: block 1 drops bench K4 (channel 1); block 2 kills the ARM permit (channel 2), so the shunt re-closes. Positive (direct) opening action required. |
| TBD | FIRE pushbutton, guarded momentary, 2 NO + 1 NC auxiliary | TBD | S_FIRE | 1 | -- | -- | Mouser | DigiKey | Batch 2: two NO poles switch both wires of the floating FIRE loop; the NC auxiliary blocks RESET while the actuator is held or stuck. NOT an SMD tactile (D-044). |
| TBD | TEST pushbutton, momentary, panel mount | TBD | S_TEST | 1 | -- | -- | Mouser | DigiKey | Batch 2 (D-B), pending sign-off. Momentary ONLY, never latching: the shunt is open while it is held (H10). |
| TBD | RESET pushbutton, momentary, panel mount | TBD | S_RESET | 1 | -- | -- | Mouser | DigiKey | Batch 2: sets the K5 ARM permit, only with E-STOP released, FIRE released and the key OFF. |
| Pending decision | Relay SPDT 12 V - latched ARM permit | SRD-12VDC-SL-C | K5 | 1 | C30431 | -- | Mouser | DigiKey | Batch 2 (P-04 C), pending sign-off. Same part as the bench relays. Self-holds from E-STOP block 2, so releasing the E-STOP does not re-arm without RESET. A welded K5 loses only that anti-restart property. |
| Pending decision | Switching diode - K5 flyback | 1N4148W | D_K5 | 1 | C81598 | UNIT | Mouser | DigiKey |  |

### TELEMETRY & USB

| Status | Component name | ID # (part number) | Designator | Amount | LCSC | UNIT Electronics | Mouser MX | DigiKey MX | Notes |
|---|---|---|---|---|---|---|---|---|---|
| In lab | USB-C 16-pin (USB 2.0) | TYPE-C-31-M-12 | J_USB | 1 | C165948 | UNIT | Mouser | DigiKey | On the STATION board, not the bench. Direct USB down a 20 m umbilical is out of spec (D-038). |
| In lab | USB ESD diode, 5 V bidirectional | ESD9B5.0ST5G | D_ESD1, D_ESD2 | 2 | C111566 | UNIT | Mouser | DigiKey | SOD-923, one per data line. Alt: USBLC6-2SC6 (C7519). |
| Pending part | USB-UART bridge | CH340C / FT232RL  [CANDIDATE] | U_USB | 1 | -- | UNIT | Mouser | DigiKey | No MCU needed on the station for safety. A bridge is sufficient. CH340C is LCSC-stocked and cheap. |
| New (approved) | RS-485 transceiver, 3.3 V, half-duplex | SP3485EN-L/TR | U_485 | 1 | C8963 | -- | Mouser | DigiKey | Station end, on the BENCH-REFERENCED side of the ground barrier, powered from the umbilical. |
| Pending part | Digital isolator / high-speed optocoupler - ground barrier | 6N137 or digital isolator  [CANDIDATE] | U_ISO | 2 | -- | -- | Mouser | DigiKey | Sits between the bench-referenced side and the USB side. NOT YET VERIFIED for price or stock. The TLP521/PC817 already in stock are too slow to be relied on at 115200 baud - do not substitute them without measuring. |

### MEASUREMENT OUTPUT

| Status | Component name | ID # (part number) | Designator | Amount | LCSC | UNIT Electronics | Mouser MX | DigiKey MX | Notes |
|---|---|---|---|---|---|---|---|---|---|
| TBD | Differential receiver for the thrust pair | TBD | U_RX | 1 | -- | -- | Mouser | DigiKey | Recovers the thrust signal and presents 0-5 V to a DAQ. |
| TBD | DAQ output connector (BNC or terminal) | TBD | J_DAQ | 1 | -- | -- | Mouser | DigiKey | Path 2 must work with no software at all. |
| TBD | Battery voltage display module | TBD | U_VM | 1 | -- | UNIT | -- | -- | Wirikuta used a digital voltmeter module (manual p. 19). Pre-test check requires at least 12 V read remotely (manual p. 12). |

### INDICATORS & AUDIO

| Status | Component name | ID # (part number) | Designator | Amount | LCSC | UNIT Electronics | Mouser MX | DigiKey MX | Notes |
|---|---|---|---|---|---|---|---|---|---|
| In lab | Red LED 0805 | NCD0805R1 | D_ARMED, D_CONT, D_PWR | 3+ | C84256 | UNIT | Mouser | DigiKey | ARMED lamp must be driven from the real arm line. D_CONT is ACTIVE-HIGH since Batch 2 (sourced by the bench during TEST), so a sense-line short to ground reads 'no match'. |
| In lab | Magnetic buzzer 2.7 kHz (passive) | MLT-8530 | LS1 | 1 | C94599 | -- | Mouser | DigiKey | Audible ARMED warning. Recommended addition - the manual relies on visual cues only. |
| In lab | N-MOSFET 30 V / 270 mA (SC-70) | NTS4001NT1G | Q_BUZZ | 1 | C116738 | -- | Mouser | DigiKey | Buzzer drive. |
| In lab | Switching diode (buzzer flyback) | 1N4148W | D_BUZZ | 1 | C81598 | UNIT | Mouser | DigiKey |  |

### CONNECTORS & TEST

| Status | Component name | ID # (part number) | Designator | Amount | LCSC | UNIT Electronics | Mouser MX | DigiKey MX | Notes |
|---|---|---|---|---|---|---|---|---|---|
| TBD | Umbilical connector, keyed + strain relief | TBD | J_UMB | 1 | -- | -- | Mouser | DigiKey | Mates cable B. |
| In lab | Screw terminal 6-pin 5.08 mm | 1729160 | P1 | 1 | C457192 | -- | Mouser | DigiKey | Pyro pair, cable A. |
| New (approved) | Test point - bare pad / via | Bare pad (no part) | TP1..TP8 | ~8 | -- | -- | -- | -- | Bare pads, per D-057. |

### PASSIVES  (existing IGNIS library - 0603 R, 0805 C, D-058)

| Status | Component name | ID # (part number) | Designator | Amount | LCSC | UNIT Electronics | Mouser MX | DigiKey MX | Notes |
|---|---|---|---|---|---|---|---|---|---|
| In lab | Resistor 10 kOhm 0603 1 % | 0603WAF1002T5E | R* | ~8 | C25804 | UNIT | Mouser | DigiKey |  |
| In lab | Resistor 1 kOhm 0603 1 % | 0603WAF1001T5E | R* | ~6 | C21190 | UNIT | Mouser | DigiKey | LED series |
| In lab | Resistor 5.1 kOhm 0603 1 % | 0603WAF5101T5E | R* | 2 | C23186 | UNIT | Mouser | DigiKey | USB-C CC pull-downs |
| In lab | Resistor 22 Ohm 0603 1 % | 0603WAF220JT5E | R* | 2 | C23345 | UNIT | Mouser | DigiKey | USB data series |
| In lab | Capacitor 100 nF 50 V X7R 0805 | CC0805KRX7R9BB104 | C* | ~10 | C49678 | UNIT | Mouser | DigiKey | Now includes C_485 at the SP3485 VCC pin and C_ISO1/C_ISO2 at each 6N137 pins 8-5. The 6N137 datasheet REQUIRES that bypass and neither device had one; C_USB is shared with the CH340C and is not a local bypass. |
| In lab | Capacitor 10 uF 25 V X5R 0805 | CL21A106KAYNNNE | C* | ~4 | C15850 | UNIT | Mouser | DigiKey | Includes C_STN1 on the station 12 V entry. |
| Pending datasheet | Capacitor 22 uF 25 V X5R 0805 | CL21A226MAQNNNE | C_STN2, C_STN3 | 2 | C45783 | UNIT | Mouser | DigiKey | Rev A.1: this board previously had NO capacitor on +12V_STN, +5V_BENCH or +3V3_BENCH, while the AMS1117 uses output capacitance as its compensation - two cascaded LDOs with none are not guaranteed stable. VALUE IS ASSUMED from the datasheet stability note (22 uF solid tantalum); confirm the ceramic equivalent and ESR against the exact AMS1117 part before release - O-20. |
| TBD | Fuse and holder, station 12 V entry | TBD | F_STN | 1 | -- | -- | Mouser | DigiKey | Rev A.1: the station feed was UNFUSED while driving 20 m of ARM_LINE and three relay coils. Rating follows the station load budget and O-17. Prefer a field-replaceable blade holder, as for F1/F2. |

---

## Two findings from your existing BOMs that change the design

### 1. WS2812B cannot drive the safety beacon

IGNIS v5 and MAGNIS v1 both use `WS2812B-B/T` addressable RGB LEDs for status. **Addressable LEDs need
a data stream from a microcontroller.** Decision D-017 requires the TALAVERA beacon to be driven from
the real ARM and FIRE lines so that it cannot misreport state — which a WS2812B, by construction,
always can. The safety beacon must therefore be **plain LEDs wired to the actual signals**. WS2812B is
kept only for logger-local status, where a wrong colour costs nothing.

### 2. SKRPABE010 is the wrong control for FIRE

The 4.6 x 3.2 mm SMD tactile switch used across both boards is fine for a continuity test. It is not an
appropriate control for commanding a pyrotechnic event: it can be actuated by a dropped tool, a closing
lid, or a thumb that slipped. **FIRE needs a substantial panel-mount momentary button**, ideally
guarded. Since Batch 2 the continuity TEST is a panel momentary too (S_TEST), because the shunt is
open while it is held (H10).

---

## Reused from IGNIS v4 / 2v2 — with one important exception

`Pyros.SchDoc` in IGNIS v4 and 2v2 implements a two-channel pyro stage: `PYRO_CHx_GATE` through an
optocoupler to an S8050 NPN driving an NCE6005AR low-side MOSFET, with a second optocoupler across the
e-match returning `PYRO_CHx_CONT` for continuity. That continuity topology is **directly reusable** and
is the basis for the station's continuity check.

**The gate-drive half is not reusable.** In IGNIS the microcontroller gates the pyro channel. In
TALAVERA it must not — arming and firing are relay contacts and a hand-inserted plug (D-013). Porting
`Pyros.SchDoc` wholesale would reintroduce exactly the MCU-in-the-firing-path arrangement this redesign
exists to remove. Take the sense circuit; leave the gate drive.

One constraint carries over regardless: the continuity TEST current flows **through the e-match**, so
`R_TEST1` and `R_TEST2` must each, alone, hold it below the no-fire rating. Those values cannot be
computed until the e-match part is known (O-1).
