sofi1209/TALAVERA-v1-TestBench/exports/2026-11-10-revA2/talavera-bench-schematic.pdf

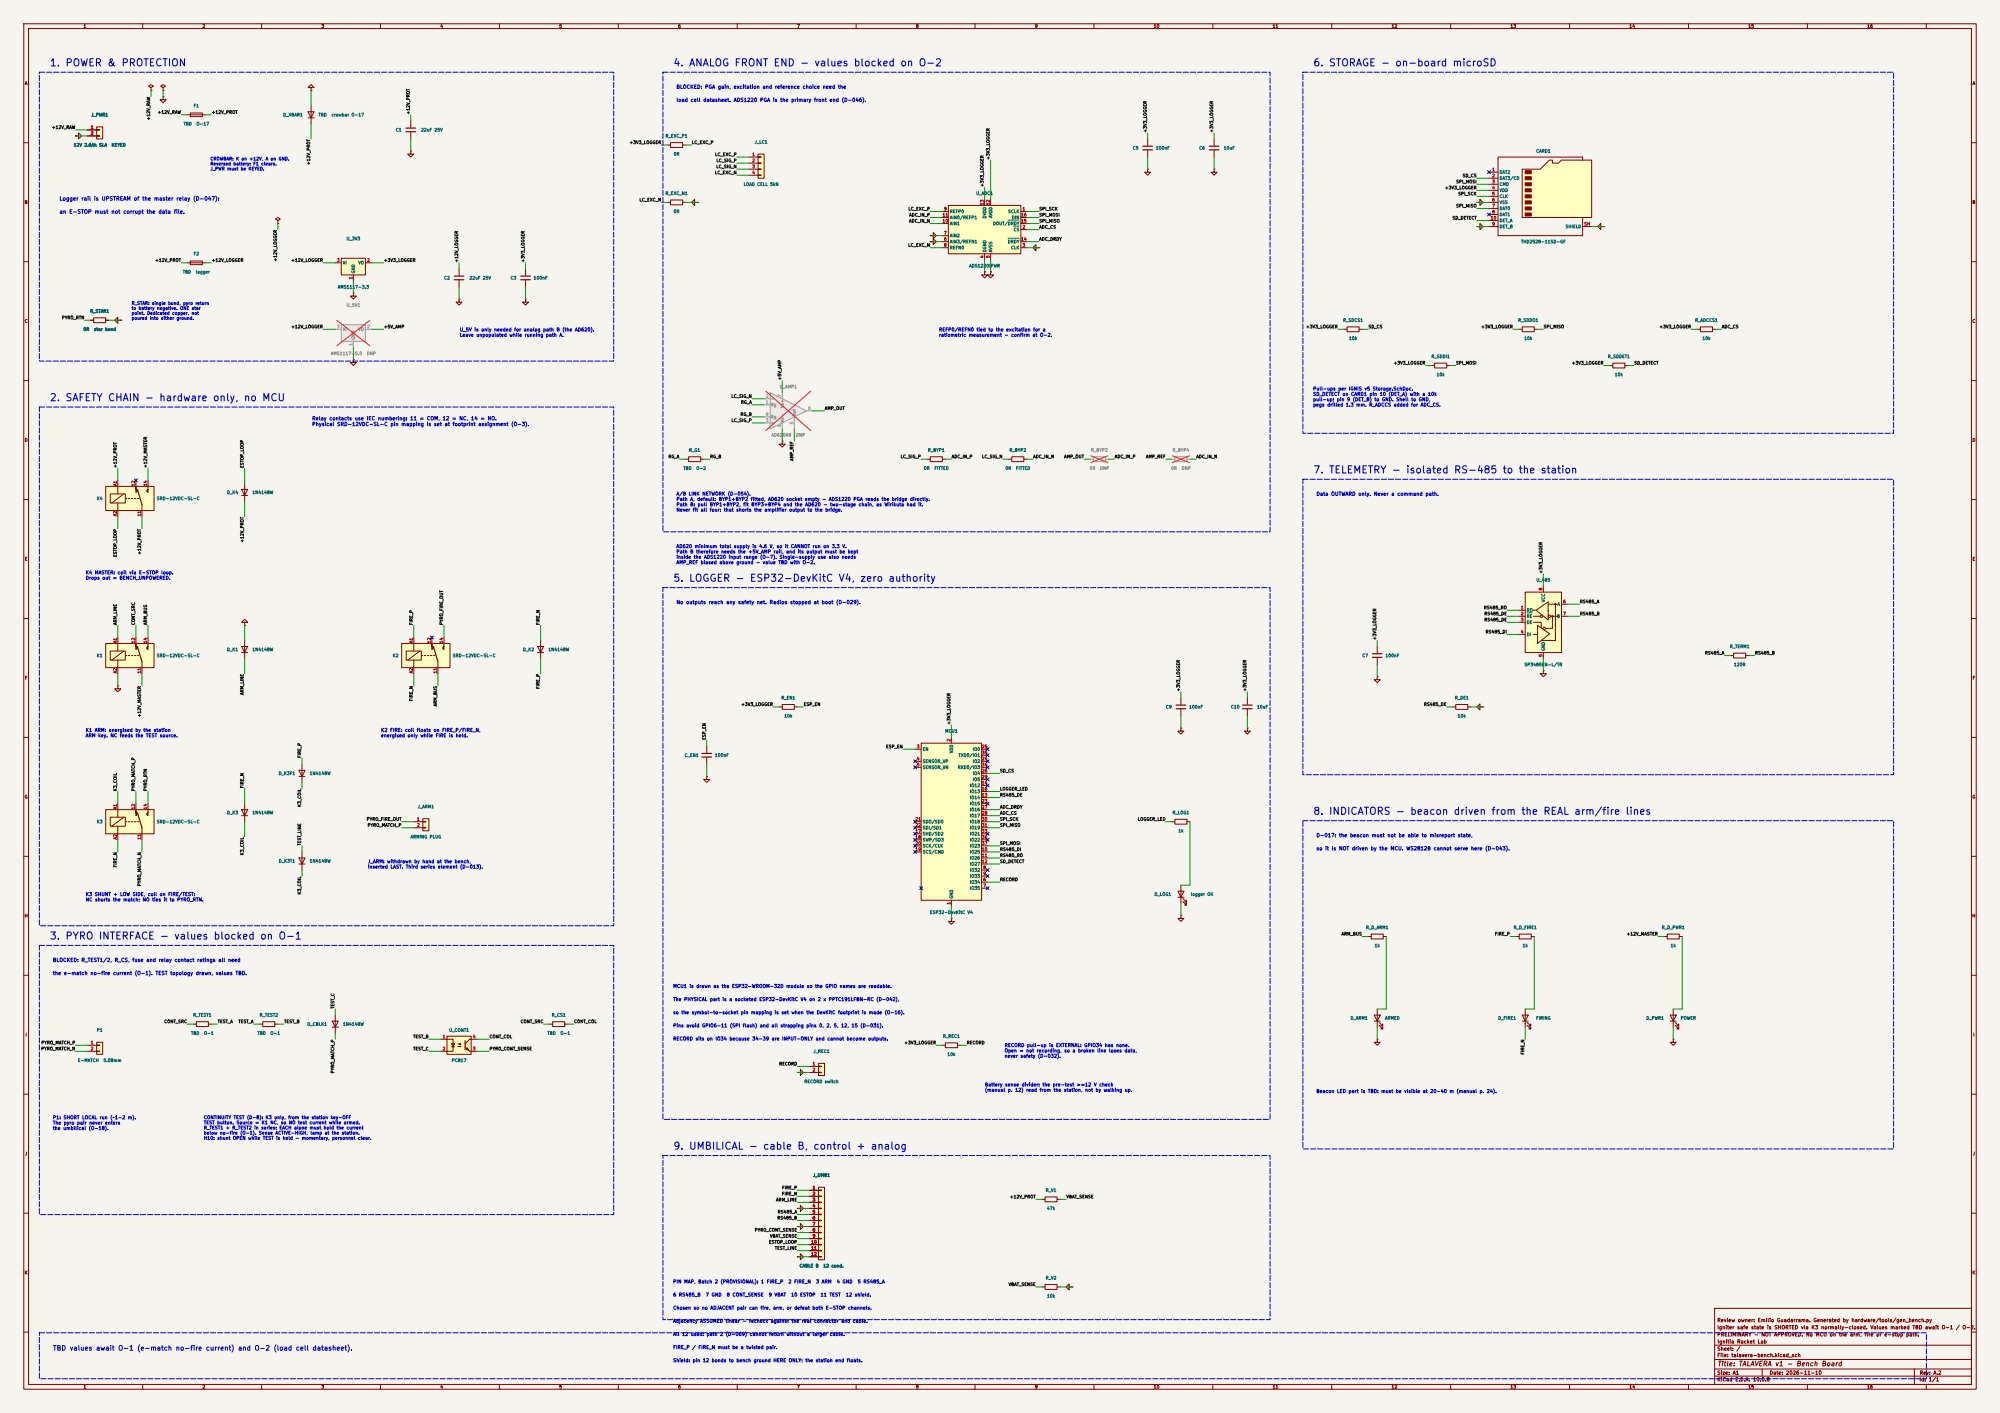
[picture p1: page 1]

4. ANALOG FRONT END - values blocked on O-2

6. STORAGE - on-board microSD

BLOCKED: PGA gain, excitation and reference choice need the CROWBAR: K on +12V, A on GND. Reversed battery: F1 clears. J_PWR must be KEYED.

load cell datasheet. ADS1220 PGA is the primary front end (D-046).

Logger rail is UPSTREAM of the master relay (D-047):

Physical SRD-12VDC-SL-C pin mapping is set at footprint assignment (O-3). an E-STOP must not corrupt the data file.

R_STAR: single bond, pyro return
to battery negative. ONE star point. Dedicated copper, not poured into either ground.

U_5V is only needed for analog path B (the AD620).
Leave unpopulated while running path A.

REFP0/REFN0 tied to the excitation for a
ratiometric measurement - confirm at O-2.

Pull-ups per IGNIS v5 Storage.SchDoc.
SD_DETECT on CARD1 pin 10 (DET_A) with a 10k
pull-up; pin 9 (DET_B) to GND. Shell to GND,
pegs drilled 1.3 mm. R_ADCCS added for ADC_CS.

2. SAFETY CHAIN - hardware only, no MCU

Relay contacts use IEC numbering: 11 = COM, 12 = NC, 14 = NO.

7. TELEMETRY - isolated RS-485 to the station

A/B LINK NETWORK (D-054).
Path A, default: BYP1+BYP2 fitted, AD620 socket empty - ADS1220 PGA reads the bridge directly.
Path B: pull BYP1+BYP2, fit BYP3+BYP4 and the AD620 - two-stage chain, as Wirikuta had it.
Never fit all four: that shorts the amplifier output to the bridge.

Data OUTWARD only. Never a command path.

Path B therefore needs the +5V_AMP rail, and its output must be kept
inside the ADS1220 input range (O-7). Single-supply use also needs
AMP_REF biased above ground - value TBD with O-2.
5. LOGGER - ESP32-DevKitC V4, zero authority

K4 MASTER: coil via E-STOP loop.
Drops out = BENCH_UNPOWERED.

No outputs reach any safety net. Radios stopped at boot (D-029).

K1 ARM: energised by the station

K2 FIRE: coil floats on FIRE_P/FIRE_N,
energised only while FIRE is held.

8. INDICATORS - beacon driven from the REAL arm/fire lines

D-017: the beacon must not be able to misreport state,

so it is NOT driven by the MCU. WS2812B cannot serve here (D-043).

J_ARM: withdrawn by hand at the bench,
inserted LAST. Third series element (D-013).

K3 SHUNT + LOW SIDE, coil on FIRE/TEST:
NC shorts the match; NO ties it to PYRO_RTN.

3. PYRO INTERFACE - values blocked on O-1

BLOCKED: R_TEST1/2, R_CS, fuse and relay contact ratings all need

the e-match no-fire current (O-1). TEST topology drawn, values TBD.

MCU1 is drawn as the ESP32-WROOM-32D module so the GPIO names are readable.

The PHYSICAL part is a socketed ESP32-DevKitC V4 on 2 x PPTC191LFBN-RC (D-042), so the symbol-to-socket pin mapping is set when the DevKitC footprint is made (O-16).

Pins avoid GPIO6-11 (SPI flash) and all strapping pins 0, 2, 5, 12, 15 (D-031).

RECORD sits on IO34 because 34-39 are INPUT-ONLY and cannot become outputs.

Battery sense divider: the pre-test >=12 V check
(manual p. 12) read from the station, not by walking up.

Beacon LED part is TBD: must be visible at 20-40 m (manual p. 24).

P1: SHORT LOCAL run (~1-2 m).
The pyro pair never enters
the umbilical (O-18).

CONTINUITY TEST (D-B): K3 only, from the station key-OFF
TEST button. Source = K1 NC, so NO test current while armed. R_TEST1 + R_TEST2 in series: EACH alone must hold the current below no-fire (O-1). Sense ACTIVE-HIGH, lamp at the station. H10: shunt OPEN while TEST is held - momentary, personnel clear.

9. UMBILICAL - cable B, control + analog
J_UMB1 CABLE B 12 cond.

PIN MAP, Batch 2 (PROVISIONAL): 1 FIRE_P 2 FIRE_N 3 ARM 4 GND 5 RS485_A

6 RS485_B 7 GND 8 CONT_SENSE 9 VBAT 10 ESTOP 11 TEST 12 shield.

Chosen so no ADJACENT pair can fire, arm, or defeat both E-STOP channels.

Adjacency ASSUMED linear - recheck against the real connector and cable.

Review owner: Emilio Guadarrama. Generated by hardware/tools/gen_bench.py
Igniter safe state is SHORTED via K3 normally-closed. Values marked TBD await O-1 / O-2.

All 12 used: path 2 (D-069) cannot return without a larger cable. TBD values await O-1 (e-match no-fire current) and O-2 (load cell datasheet). FIRE_P / FIRE_N must be a twisted pair. Shield: pin 12 bonds to bench ground HERE ONLY; the station end floats. | PRELIMINARY - NOT APPROVED. No MCU on the arm, fire or e-stop path. Ignitia Rocket Lab

Sheet: / File: talavera-bench.kicad_sch

Title: TALAVERA v1 - Bench Board
Size: A1 | | Rev: A.2
