sofi1209/TALAVERA-v1-TestBench/exports/2026-11-10-revA2/netlist-diff-vs-main-bench.txt

components: 62 -> 67
  + D_CBLK1      1N4148W
  + D_K3F1       1N4148W
  + D_K3T1       1N4148W
  + D_XBAR1      TBD  crowbar O-17
  + R_CS1        TBD  O-1
  + R_TEST1      TBD  O-1
  + R_TEST2      TBD  O-1
  - D_RP1        SS24
  - R_CONT1      TBD  O-1
  ~ J_PWR1       12V 2.6Ah SLA  ->  12V 2.6Ah SLA  KEYED
nets: 48 -> 54
  + CONT_COL           R_CS1.2 U_CONT1.4
  + CONT_SRC           K1.12 R_CS1.1 R_TEST1.1
  + FIRE_N             D_FIRE1.1 D_K2.2 D_K3.2 J_UMB1.2 K2.A2 K3.A2
  + FIRE_P             D_K2.1 D_K3F1.2 J_UMB1.1 K2.A1 R_D_FIRE1.1
  + K3_COIL            D_K3.1 D_K3F1.1 D_K3T1.1 K3.A1
  + TEST_A             R_TEST1.2 R_TEST2.1
  + TEST_B             R_TEST2.2 U_CONT1.1
  + TEST_C             D_CBLK1.2 U_CONT1.2
  + TEST_LINE          D_K3T1.2 J_UMB1.11
  - +12V_FUSED         D_RP1.2 F1.2
  - CONT_LED_A         R_CONT1.2 U_CONT1.1
  - FIRE_LINE          D_K2.1 J_UMB1.2 K2.A1 R_D_FIRE1.1
  ~ +12V_PROT          +D_XBAR1.1 +F1.2  -D_RP1.1
  ~ ARM_LINE           +J_UMB1.3  -D_K3.1 -J_UMB1.1 -K3.A1
  ~ ESTOP_LOOP         +J_UMB1.10  -J_UMB1.3
  ~ GND                +D_XBAR1.2 +J_UMB1.4 +J_UMB1.7  -D_FIRE1.1 -D_K2.2 -D_K3.2 -J_UMB1.10 -J_UMB1.11 -K2.A2 -K3.A2 -U_CONT1.3
  ~ PYRO_CONT_SENSE    +J_UMB1.8 +U_CONT1.3  -J_UMB1.4 -U_CONT1.4
  ~ PYRO_MATCH_N         -U_CONT1.2
  ~ PYRO_MATCH_P       +D_CBLK1.1  -R_CONT1.1
  ~ VBAT_SENSE         +J_UMB1.9  -J_UMB1.7
nets unchanged: 37
