sofi1209/TALAVERA-v1-TestBench/hardware/tools/gen_bench.py

"""TALAVERA v1 - bench board schematic generator."""
import os
import ksch
import umbilical
from ksch import Sch

# Relative to this file, so regeneration is not tied to one machine.
OUT = os.path.join(os.path.dirname(os.path.abspath(__file__)),
                   os.pardir, "talavera-bench", "talavera-bench.kicad_sch")

s = Sch("talavera-bench", "TALAVERA v1 - Bench Board", paper="A1", scale=1.38,
        rev="A.2", date="2026-11-10",
        comments=("PRELIMINARY - NOT APPROVED. No MCU on the arm, fire or e-stop path.",
                  "Igniter safe state is SHORTED via K3 normally-closed. Values marked TBD await O-1 / O-2.",
                  "Review owner: Emilio Guadarrama. Generated by hardware/tools/gen_bench.py"))

R = "Device:R"; C = "Device:C"; D = "Device:D"; LED = "Device:LED"
SCH = "Device:D_Schottky"; FUSE = "Device:Fuse"
RLY = "Relay:Relay_SPDT"
CONN2 = "Connector_Generic:Conn_01x02"; CONN4 = "Connector_Generic:Conn_01x04"
CONN12 = "Connector_Generic:Conn_01x12"; CONN19 = "Connector_Generic:Conn_01x19"
OPTO = "Isolator:PC817"

def hdr(t, x, y):
    s.text(t, x, y, 3.0)

# ======================================================================= POWER
hdr("1. POWER & PROTECTION", 15, 18)
s.box(12, 22, 175, 88)

j = s.place(CONN2, "J_PWR", "12V 2.6Ah SLA  KEYED", 30, 40)
s.stub(j['1'], "+12V_RAW")
s.power("GND", j['2'])

# PYRO_RTN is the firing-current return, kept as its own net all the way back to
# the battery negative and bonded to GND ONLY here, at the J_PWR star point.
#
# Why this exists: the fix that gives the firing loop a return (K3 NO, below)
# would otherwise dump the full fire current - roughly 6-12 A, pending O-1 -
# into the single GND net that also carries R_EXC_N (load-cell bridge return),
# U_ADC AVSS and the ESP32 grounds, during the burn, which is the only moment
# the instrument exists to measure. It would also put a ground-borne reset on
# the logger at ignition, defeating through the ground the protection D-047
# bought by placing the logger rail upstream of K4.
#
# LAYOUT REQUIREMENT, not a suggestion: PYRO_RTN is a dedicated copper path from
# K3 to this link. It may not be poured into the analog or digital ground, and
# R_STAR is the single bond. See AUDIT-RECONCILIATION-2026-11-09.md R-1.
rstar = s.place(R, "R_STAR", "0R  star bond", 30, 98, angle=90)
s.stub(rstar['1'], "PYRO_RTN", 3)
s.power("GND", rstar['2'])
s.text("R_STAR: single bond, pyro return\nto battery negative. ONE star\npoint. Dedicated copper, not\npoured into either ground.", 40, 92, 1.3, False)

f1 = s.place(FUSE, "F1", "TBD  O-17", 60, 35, angle=90)
s.stub(f1['1'], "+12V_RAW", 3)
s.stub(f1['2'], "+12V_PROT", 3)

# P-05 (Batch 2, PROVISIONAL): reverse polarity by CROWBAR, not by a series
# diode. The series SS24 (D_RP) was a 2 A-class part in the 6-12 A fire path
# (O-1): a degraded forward drop there can push the match below all-fire and
# turn a firing into a HANG-FIRE. Now nothing semiconductor sits in series with
# the fire current. A reversed battery forward-biases D_XBAR and F1 clears.
# Polarity: ANODE on GND, CATHODE on +12V_PROT, so it is reverse-biased in
# normal use. Pin 1 is K and pin 2 is A on Device:D.
# NOT SIZED: D_XBAR must survive F1's clearing I2t at the battery's short-circuit
# current, which is unknown (SLA maker and Isc not recorded) - O-17. Pair with a
# KEYED battery connector so reversal is mechanically unlikely in the first place.
dx = s.place(D, "D_XBAR", "TBD  crowbar O-17", 95, 35, angle=90)
s.stub(dx['1'], "+12V_PROT", 6)
s.power("GND", dx['2'], 6)
s.text("CROWBAR: K on +12V, A on GND.\nReversed battery: F1 clears.\nJ_PWR must be KEYED.", 64, 48, 1.3, False)

s.pwr_flag("+12V_RAW", 46, 28)
s.pwr_flag("GND", 50, 28)
c1 = s.place(C, "C1", "22uF 25V", 125, 40)
s.stub(c1['1'], "+12V_PROT", 3)
s.power("GND", c1['2'])

# logger rail - UPSTREAM of the master relay (D-047), own fuse
s.text("Logger rail is UPSTREAM of the master relay (D-047):", 18, 60, 1.6, True)
s.text("an E-STOP must not corrupt the data file.", 18, 64, 1.6, False)

f2 = s.place(FUSE, "F2", "TBD  logger", 60, 80, angle=90)
s.stub(f2['1'], "+12V_PROT", 3)
s.stub(f2['2'], "+12V_LOGGER", 3)
# ERC does not propagate a power source through a passive, so every rail that
# feeds a power_input pin needs its own driver. Without this, U_3V3 pin 3 (VI)
# raised power_pin_not_driven - the one real ERC error on this board.
s.pwr_flag("+12V_LOGGER", 85, 68)

u3 = s.place("Regulator_Linear:AMS1117-3.3", "U_3V3", "AMS1117-3.3", 108, 80)
s.stub(u3['3'], "+12V_LOGGER")     # VI
s.power("GND", u3['1'])            # GND
s.stub(u3['2'], "+3V3_LOGGER")     # VO

u5 = s.place("Regulator_Linear:AMS1117-5.0", "U_5V", "AMS1117-5.0  DNP", 108, 100, dnp=True)
s.stub(u5['3'], "+12V_LOGGER")     # VI
s.power("GND", u5['1'])            # GND
s.stub(u5['2'], "+5V_AMP")         # VO
s.text("U_5V is only needed for analog path B (the AD620).\nLeave unpopulated while running path A.", 140, 100, 1.4, False)

c2 = s.place(C, "C2", "22uF 25V", 140, 85)
s.stub(c2['1'], "+12V_LOGGER", 3); s.power("GND", c2['2'])
c3 = s.place(C, "C3", "100nF", 160, 85)
s.stub(c3['1'], "+3V3_LOGGER", 3); s.power("GND", c3['2'])

# ================================================================ SAFETY CHAIN
hdr("2. SAFETY CHAIN - hardware only, no MCU", 15, 120)
s.box(12, 124, 175, 158)
s.text("Relay contacts use IEC numbering: 11 = COM, 12 = NC, 14 = NO.\n"
       "Physical SRD-12VDC-SL-C pin mapping is set at footprint assignment (O-3).",
       95, 127, 1.5, False)

def relay(ref, value, x, y, coil_hi, coil_lo, com, no, nc, note):
    k = s.place(RLY, ref, value, x, y)
    s.stub(k['A1'], coil_hi)
    s.stub(k['A2'], coil_lo)
    if com: s.stub(k['11'], com)
    if no:  s.stub(k['14'], no)
    if nc:  s.stub(k['12'], nc)
    s.text(note, x - 14, y + 22, 1.4, False)
    return k

# K4 master: held in by its coil; E-STOP breaks the coil circuit
_k4 = relay("K4", "SRD-12VDC-SL-C", 40, 152, "+12V_PROT", "ESTOP_LOOP",
      "+12V_PROT", "+12V_MASTER", None,
      "K4 MASTER: coil via E-STOP loop.\nDrops out = BENCH_UNPOWERED.")
d4 = s.place(D, "D_K4", "1N4148W", 75, 150, angle=90)
s.stub(d4['1'], "+12V_PROT", 6); s.stub(d4['2'], "ESTOP_LOOP", 6)   # C-3: K to +ve

# K1 arm. Its NC contact (12) is the continuity TEST source, CONT_SRC: live only
# while K1 is de-energised, so the test current mechanically cannot exist while
# ARM_BUS is live (P-01, Batch 2, PROVISIONAL). That exclusivity rests on the
# same Form C break-before-make question as K3 (O-3).
_k1 = relay("K1", "SRD-12VDC-SL-C", 40, 200, "ARM_LINE", "GND",
      "+12V_MASTER", "ARM_BUS", "CONT_SRC",
      "K1 ARM: energised by the station\nARM key. NC feeds the TEST source.")
d5 = s.place(D, "D_K1", "1N4148W", 75, 198, angle=90)
s.stub(d5['1'], "ARM_LINE", 6); s.stub(d5['2'], "GND", 6)           # C-3: K to +ve

# K2 fire. P-03 (Batch 2, PROVISIONAL): the FIRE command is a FLOATING two-wire
# loop, FIRE_P / FIRE_N, and the K2 coil sits between them - it is not returned
# to bench GND. The station FIRE button is double-pole (ARM_LINE -> FIRE_P and
# FIRE_N -> GND), so a single umbilical short of either FIRE wire to ARM_LINE or
# to ground cannot energise the coil. With the old single FIRE_LINE, an ARM/FIRE
# short (adjacent pins 1/2) fired the bench the moment it was armed.
_k2 = relay("K2", "SRD-12VDC-SL-C", 130, 200, "FIRE_P", "FIRE_N",
      "ARM_BUS", "PYRO_FIRE_OUT", None,
      "K2 FIRE: coil floats on FIRE_P/FIRE_N,\nenergised only while FIRE is held.")
d6 = s.place(D, "D_K2", "1N4148W", 165, 198, angle=90)
s.stub(d6['1'], "FIRE_P", 6); s.stub(d6['2'], "FIRE_N", 6)          # K on A1 side

# K3 shunt AND low-side return, on one Form C pole: COM on MATCH_N, NC to
# MATCH_P, NO to PYRO_RTN (D-065, contacts unchanged).
#   de-energised -> match shorted AND isolated from the return (safe state)
#   energised    -> shunt open, low side tied to the return
#
# P-02 (Batch 2, PROVISIONAL): the COIL now follows the FIRE command, not ARM.
# Before, ARM energised K1 and K3 together, so a single welded K2 contact fired
# the bench on ARM, and the shunt was open for the whole armed wait. Now:
#   - a K2 weld alone, or a K3 weld alone, cannot fire;
#   - the shunt stays closed and isolated through the armed period (H2), and
#     opens only while FIRE (or TEST) is held;
#   - the NC can only ever close onto MATCH_N while MATCH_N is isolated, so
#     there is no state in which the shunt sits across a live source.
# The coil floats on K3_COIL / FIRE_N, fed from FIRE_P or TEST_LINE through
# D_K3F / D_K3T. A ground-returned K3 was tried first and REJECTED: with it,
# an ARM_LINE-to-FIRE_N short (adjacent pins 2/3) forward-biases D_K2 and
# D_K3F and pulls K3 in while ARMED - shunt open, one K2 weld from firing.
# trace_fire_loop.py reproduces this as a gated failure when K3 is redrawn to
# GND (self-test, Batch 2).
# TEST returns through FIRE_N, which the station key grounds ONLY in OFF.
#
# Break-before-make (O-3) no longer decides ignition safety, but it still
# decides contact life: under make-before-break K3 bridges NC-COM-NO at EVERY
# fire if K2 has already closed. Measure it on real units before Gate 6.
_k3 = relay("K3", "SRD-12VDC-SL-C", 40, 250, "K3_COIL", "FIRE_N",
      "PYRO_MATCH_N", "PYRO_RTN", "PYRO_MATCH_P",
      "K3 SHUNT + LOW SIDE, coil on FIRE/TEST:\nNC shorts the match; NO ties it to PYRO_RTN.")
d7 = s.place(D, "D_K3", "1N4148W", 75, 248, angle=90)
s.stub(d7['1'], "K3_COIL", 6); s.stub(d7['2'], "FIRE_N", 6)         # K on A1 side
d8 = s.place(D, "D_K3F", "1N4148W", 92, 236, angle=90)
s.stub(d8['2'], "FIRE_P", 3); s.stub(d8['1'], "K3_COIL", 3)          # A FIRE_P, K coil
d9 = s.place(D, "D_K3T", "1N4148W", 92, 262, angle=90)
s.stub(d9['2'], "TEST_LINE", 3); s.stub(d9['1'], "K3_COIL", 3)       # A TEST, K coil

s.nc(_k2['12'], _k4['12'])   # unused relay contacts

# arming plug - third series element
ja = s.place(CONN2, "J_ARM", "ARMING PLUG", 130, 250)
s.stub(ja['1'], "PYRO_FIRE_OUT")
s.stub(ja['2'], "PYRO_MATCH_P")
s.text("J_ARM: withdrawn by hand at the bench,\ninserted LAST. Third series element (D-013).", 112, 262, 1.4, False)

# ================================================================ PYRO (O-1)
hdr("3. PYRO INTERFACE - values blocked on O-1", 15, 284)
s.box(12, 288, 175, 82)
s.text("BLOCKED: R_TEST1/2, R_CS, fuse and relay contact ratings all need", 16, 292, 1.5, False)
s.text("the e-match no-fire current (O-1). TEST topology drawn, values TBD.", 16, 296, 1.5, False)

p1 = s.place(CONN2, "P1", "E-MATCH  5.08mm", 30, 318)
s.stub(p1['1'], "PYRO_MATCH_P")
s.stub(p1['2'], "PYRO_MATCH_N")
s.text("P1: SHORT LOCAL run (~1-2 m).\nThe pyro pair never enters\nthe umbilical (O-18).", 16, 340, 1.4, False)

# P-01 (Batch 2, PROVISIONAL): pre-arm continuity TEST, station-commanded.
# Key OFF -> TEST button -> TEST_LINE energises K3 ONLY (K1 stays out), which
# opens the shunt and ties MATCH_N to the return. The test current comes from
# K1's NC contact (CONT_SRC), so it cannot exist while ARM_BUS is live:
#   CONT_SRC -> R_TEST1 -> R_TEST2 -> opto LED -> D_CBLK -> MATCH_P -> match
#            -> MATCH_N -> K3 NO -> PYRO_RTN.
# TWO series resistors so that one failing short still keeps the current below
# the no-fire figure - each alone must be sufficient. Values are BLOCKED on O-1.
# D_CBLK blocks the 12 V that MATCH_P carries during FIRE from reverse-biasing
# the opto LED. The old R_CONT + LED in PARALLEL with the match is deleted: it
# had no source, could never light, and took the full rail after a burn-through.
# Sense is ACTIVE-HIGH and sourced from CONT_SRC too, so a short of the sense
# conductor to ground reads "no continuity", and the lamp cannot light armed.
# H10: the shunt is open for the duration of a TEST. Momentary only, personnel
# clear - an accepted hazard for the review owner, not a solved one.
for _ref, _a, _b, _x in [("R_TEST1", "CONT_SRC", "TEST_A", 62),
                         ("R_TEST2", "TEST_A", "TEST_B", 82)]:
    _r = s.place(R, _ref, "TBD  O-1", _x, 312, angle=90)
    s.stub(_r['1'], _a, 3); s.stub(_r['2'], _b, 3)
dcb = s.place(D, "D_CBLK", "1N4148W", 102, 312, angle=90)
s.stub(dcb['2'], "TEST_C", 3); s.stub(dcb['1'], "PYRO_MATCH_P", 3)  # A LED side, K match
oc = s.place(OPTO, "U_CONT", "PC817", 140, 318)
s.stub(oc['1'], "TEST_B")            # LED anode
s.stub(oc['2'], "TEST_C")            # LED cathode, on to D_CBLK
s.stub(oc['4'], "CONT_COL")          # collector, fed from CONT_SRC via R_CS
s.stub(oc['3'], "PYRO_CONT_SENSE")   # emitter drives the sense line HIGH
rcs = s.place(R, "R_CS", "TBD  O-1", 170, 312, angle=90)
s.stub(rcs['1'], "CONT_SRC", 3); s.stub(rcs['2'], "CONT_COL", 3)
s.text("CONTINUITY TEST (D-B): K3 only, from the station key-OFF\n"
       "TEST button. Source = K1 NC, so NO test current while armed.\n"
       "R_TEST1 + R_TEST2 in series: EACH alone must hold the current\n"
       "below no-fire (O-1). Sense ACTIVE-HIGH, lamp at the station.\n"
       "H10: shunt OPEN while TEST is held - momentary, personnel clear.", 62, 340, 1.35, False)

# ========================================================== ANALOG (O-2)
hdr("4. ANALOG FRONT END - values blocked on O-2", 205, 18)
s.box(202, 22, 185, 140)
s.text("BLOCKED: PGA gain, excitation and reference choice need the", 206, 26, 1.5, False)
s.text("load cell datasheet. ADS1220 PGA is the primary front end (D-046).", 206, 30, 1.5, False)

rex = s.place(R, "R_EXC_P", "0R", 206, 44, angle=90)
s.stub(rex['1'], "+3V3_LOGGER", 3); s.stub(rex['2'], "LC_EXC_P", 3)
rexn = s.place(R, "R_EXC_N", "0R", 206, 62, angle=90)
s.stub(rexn['1'], "LC_EXC_N", 3); s.power("GND", rexn['2'])
jlc = s.place(CONN4, "J_LC", "LOAD CELL 5kN", 232, 50)
s.stub(jlc['1'], "LC_EXC_P"); s.stub(jlc['2'], "LC_SIG_P")
s.stub(jlc['3'], "LC_SIG_N"); s.stub(jlc['4'], "LC_EXC_N")

adc = s.place("Analog_ADC:ADS1220xPW", "U_ADC", "ADS1220IPWR", 300, 70)
s.stub(adc['11'], "ADC_IN_P")      # AIN0 - fed by the link network below
s.stub(adc['10'], "ADC_IN_N")      # AIN1
s.stub(adc['9'],  "LC_EXC_P")      # REFP0  - ratiometric, verify O-2
s.stub(adc['8'],  "LC_EXC_N")      # REFN0
s.power("GND", adc['7'])           # AIN2 unused - tied, not floating
s.power("GND", adc['6'])           # AIN3 unused
s.power("GND", adc['3'])           # CLK unused -> internal oscillator
s.stub(adc['13'], "+3V3_LOGGER", 5.08)   # DVDD  (C-1)
s.stub(adc['12'], "+3V3_LOGGER", 16.51)  # AVDD  (C-1)
s.power("GND", adc['4'])           # DGND
s.power("GND", adc['5'])           # AVSS
s.stub(adc['1'],  "SPI_SCK")
s.stub(adc['2'],  "ADC_CS")
s.stub(adc['16'], "SPI_MOSI")
s.stub(adc['15'], "SPI_MISO")
s.stub(adc['14'], "ADC_DRDY")
s.text("REFP0/REFN0 tied to the excitation for a\nratiometric measurement - confirm at O-2.", 286, 100, 1.4, False)

c5 = s.place(C, "C5", "100nF", 350, 45); s.stub(c5['1'], "+3V3_LOGGER", 3); s.power("GND", c5['2'])
c6 = s.place(C, "C6", "10uF", 370, 45);  s.stub(c6['1'], "+3V3_LOGGER", 3); s.power("GND", c6['2'])

# AD620 - DIP-8 socket, depopulated by default, bypass links fitted
amp = s.place("Amplifier_Instrumentation:AD620", "U_AMP", "AD620AN  DNP", 240, 125, dnp=True)
s.stub(amp['2'], "LC_SIG_N"); s.stub(amp['3'], "LC_SIG_P")
s.stub(amp['1'], "RG_A"); s.stub(amp['8'], "RG_B")
s.stub(amp['6'], "AMP_OUT")
s.stub(amp['7'], "+5V_AMP")        # AD620 needs >= 4.6 V total supply - NOT 3.3 V
s.power("GND", amp['4'])
s.text("AD620 minimum total supply is 4.6 V, so it CANNOT run on 3.3 V.\n"
       "Path B therefore needs the +5V_AMP rail, and its output must be kept\n"
       "inside the ADS1220 input range (O-7). Single-supply use also needs\n"
       "AMP_REF biased above ground - value TBD with O-2.", 206, 166, 1.4, False)
rg = s.place(R, "R_G", "TBD  O-2", 212, 140, angle=90)
s.stub(rg['1'], "RG_A", 3); s.stub(rg['2'], "RG_B", 3)

# A/B link network: path A = PGA only (default), path B = AD620 ahead of the ADC
for ref, a, b, fit, xx in [("R_BYP1", "LC_SIG_P", "ADC_IN_P", "0R  FITTED", 285),
                           ("R_BYP2", "LC_SIG_N", "ADC_IN_N", "0R  FITTED", 310),
                           ("R_BYP3", "AMP_OUT", "ADC_IN_P", "0R  DNP", 335),
                           ("R_BYP4", "AMP_REF", "ADC_IN_N", "0R  DNP", 360)]:
    lk = s.place(R, ref, fit, xx, 140, angle=90, dnp=("DNP" in fit))
    s.stub(lk['1'], a, 3); s.stub(lk['2'], b, 3)
s.stub(amp['5'], "AMP_REF")   # Ref pin also brought to the link network

s.text("A/B LINK NETWORK (D-054).\n"
       "Path A, default: BYP1+BYP2 fitted, AD620 socket empty - ADS1220 PGA reads the bridge directly.\n"
       "Path B: pull BYP1+BYP2, fit BYP3+BYP4 and the AD620 - two-stage chain, as Wirikuta had it.\n"
       "Never fit all four: that shorts the amplifier output to the bridge.", 206, 150, 1.4, False)

# ==================================================================== LOGGER
hdr("5. LOGGER - ESP32-DevKitC V4, zero authority", 205, 175)
s.box(202, 179, 185, 162)
s.text("No outputs reach any safety net. Radios stopped at boot (D-029).", 206, 183, 1.5, False)

mcu = s.place("RF_Module:ESP32-WROOM-32D", "MCU1", "ESP32-DevKitC V4", 290, 250)
s.stub(mcu['2'], "+3V3_LOGGER")    # VDD   (C-1)
s.power("GND", mcu['1'])           # GND
# shared VSPI bus: one SCK/MOSI/MISO, a separate chip select per device
for pn, net in [('30', "SPI_SCK"),    # IO18
                ('37', "SPI_MOSI"),   # IO23
                ('31', "SPI_MISO"),   # IO19
                ('28', "ADC_CS"),     # IO17
                ('27', "ADC_DRDY"),   # IO16
                ('26', "SD_CS"),      # IO4
                ('12', "SD_DETECT"),  # IO27
                ('6',  "RECORD"),     # IO34 - input only, no internal pull-up
                ('16', "LOGGER_LED"), # IO13
                ('10', "RS485_DI"),   # IO25  UART2 TX
                ('11', "RS485_RO"),   # IO26  UART2 RX
                ('13', "RS485_DE")]:  # IO14
    s.stub(mcu[pn], net)
# M-4: pins that are deliberately open get explicit no-connect flags.
# GPIO6-11 are the module's internal SPI flash and are never usable.
s.nc(*[mcu[pn] for pn in ['4','5','17','18','19','20','21','22','32',
                          '24','25','34','35','23','14','8','9',
                          '33','36','29','7']])
ren = s.place(R, "R_EN", "10k", 240, 215, angle=90)
s.stub(ren['1'], "+3V3_LOGGER", 3); s.stub(ren['2'], "ESP_EN", 3)
s.stub(mcu['3'], "ESP_EN")         # EN
cen = s.place(C, "C_EN", "100nF", 215, 230)
s.stub(cen['1'], "ESP_EN", 3); s.power("GND", cen['2'])
c9 = s.place(C, "C9", "100nF", 360, 215); s.stub(c9['1'], "+3V3_LOGGER", 3); s.power("GND", c9['2'])
c10 = s.place(C, "C10", "10uF", 380, 215); s.stub(c10['1'], "+3V3_LOGGER", 3); s.power("GND", c10['2'])

for _i, _ln in enumerate([
        "MCU1 is drawn as the ESP32-WROOM-32D module so the GPIO names are readable.",
        "The PHYSICAL part is a socketed ESP32-DevKitC V4 on 2 x PPTC191LFBN-RC (D-042),",
        "so the symbol-to-socket pin mapping is set when the DevKitC footprint is made (O-16).",
        "Pins avoid GPIO6-11 (SPI flash) and all strapping pins 0, 2, 5, 12, 15 (D-031).",
        "RECORD sits on IO34 because 34-39 are INPUT-ONLY and cannot become outputs."]):
    s.text(_ln, 205, 300 + _i * 4, 1.4, False)

# =================================================================== STORAGE
hdr("6. STORAGE - on-board microSD", 400, 18)
s.box(397, 22, 180, 110)
sd = s.place("Connector:Micro_SD_Card_Det2", "CARD1", "THD2528-11SD-GF", 470, 60)
s.stub(sd['2'], "SD_CS")      # DAT3/CD
s.stub(sd['3'], "SPI_MOSI")    # CMD
s.stub(sd['5'], "SPI_SCK")     # CLK
s.stub(sd['7'], "SPI_MISO")    # DAT0
s.stub(sd['4'], "+3V3_LOGGER")     # VDD   (C-1)
s.power("GND", sd['6'])
s.stub(sd['10'], "SD_DETECT")
s.nc(sd['1'], sd['8'])   # DAT2 / DAT1 unused in SPI mode
s.power("GND", sd['9'])
s.power("GND", sd['SH'])
# R_ADCCS added: ADC_CS had no pull-up while SD_CS did, so the converter's chip
# select floated through reset and boot and the ADS1220 could see spurious
# selects while the ESP32 was coming up.
for i, (ref, net) in enumerate([("R_SDCS", "SD_CS"), ("R_SDDI", "SPI_MOSI"),
                                ("R_SDDO", "SPI_MISO"), ("R_SDDET", "SD_DETECT"),
                                ("R_ADCCS", "ADC_CS")]):
    r = s.place(R, ref, "10k", 412 + i * 27, 100 + (i % 2) * 11.43, angle=90)
    s.stub(r['1'], "+3V3_LOGGER", 3); s.stub(r['2'], net, 3)
s.text("Pull-ups per IGNIS v5 Storage.SchDoc.\nSD_DETECT on CARD1 pin 10 (DET_A) with a 10k\npull-up; pin 9 (DET_B) to GND. Shell to GND,\npegs drilled 1.3 mm. R_ADCCS added for ADC_CS.", 400, 118, 1.4, False)

# ================================================================= TELEMETRY
hdr("7. TELEMETRY - isolated RS-485 to the station", 400, 142)
s.box(397, 146, 180, 90)
s.text("Data OUTWARD only. Never a command path.", 401, 150, 1.5, False)
u485 = s.place("Interface_UART:SP3485EN", "U_485", "SP3485EN-L/TR", 470, 190)
s.stub(u485['1'], "RS485_RO"); s.stub(u485['2'], "RS485_DE")
s.stub(u485['3'], "RS485_DE"); s.stub(u485['4'], "RS485_DI")
s.stub(u485['6'], "RS485_A");  s.stub(u485['7'], "RS485_B")
s.stub(u485['8'], "+3V3_LOGGER")   # VCC (C-1)
s.power("GND", u485['5'])          # GND - do NOT merge onto the line above
rt = s.place(R, "R_TERM", "120R", 530, 200, angle=90)
s.stub(rt['1'], "RS485_A", 3); s.stub(rt['2'], "RS485_B", 3)
# RS485_DE drives both DE (pin 3) and /RE (pin 2), so it selects driver or
# receiver. It had no bias at all, leaving the bench transceiver's direction
# undefined through reset and boot while sharing a 20 m bus. Pulled DOWN, so the
# unpowered and resetting states leave the DRIVER OFF.
rde = s.place(R, "R_DE", "10k", 445, 215, angle=90)
s.stub(rde['1'], "RS485_DE", 3); s.power("GND", rde['2'])
c7 = s.place(C, "C7", "100nF", 420, 200); s.stub(c7['1'], "+3V3_LOGGER", 3); s.power("GND", c7['2'])

# ================================================================ INDICATORS
hdr("8. INDICATORS - beacon driven from the REAL arm/fire lines", 400, 246)
s.box(397, 250, 180, 100)
s.text("D-017: the beacon must not be able to misreport state,", 401, 254, 1.5, False)
s.text("so it is NOT driven by the MCU. WS2812B cannot serve here (D-043).", 401, 258, 1.5, False)
# D_FIRE indicates the FIRE command, not PYRO_FIRE_OUT (D-068: on the output it
# was a sneak path to ground that read "good" on an open match). Under the
# floating FIRE loop (P-03) it sits ACROSS FIRE_P / FIRE_N, beside the K2 coil,
# so it adds no ground reference to either FIRE wire - a lamp returned to GND
# would hand FIRE_P exactly the ground path the floating loop exists to remove.
# Still hardware-only, so D-017 holds.
for i, (ref, net, rtn, lbl) in enumerate([("D_ARM", "ARM_BUS", "GND", "ARMED"),
                                          ("D_FIRE", "FIRE_P", "FIRE_N", "FIRING"),
                                          ("D_PWR", "+12V_MASTER", "GND", "POWER")]):
    rr = s.place(R, "R_" + ref, "1k", 420 + i * 45, 285, angle=90)
    s.stub(rr['1'], net, 3)
    dd = s.place(LED, ref, lbl, 420 + i * 45, 310, angle=90)
    s.lwire(rr['2'], dd['2'])
    s.stub(dd['1'], rtn)
s.text("Beacon LED part is TBD: must be visible at 20-40 m (manual p. 24).", 401, 332, 1.4, False)

# ================================================================= UMBILICAL
hdr("9. UMBILICAL - cable B, control + analog", 205, 348)
s.box(202, 352, 185, 50)
ju = s.place(CONN12, "J_UMB", "CABLE B  12 cond.", 250, 372)
# Pin map lives in umbilical.py, shared with gen_station.py and the tracer.
for pin, net in umbilical.PINS:
    s.stub(ju[pin], net)
s.power("GND", ju[umbilical.SHIELD_PIN])   # cable shield, single-point to bench ground
for _i, _ln in enumerate([
        "PIN MAP, Batch 2 (PROVISIONAL): 1 FIRE_P  2 FIRE_N  3 ARM  4 GND  5 RS485_A",
        "6 RS485_B  7 GND  8 CONT_SENSE  9 VBAT  10 ESTOP  11 TEST  12 shield.",
        "Chosen so no ADJACENT pair can fire, arm, or defeat both E-STOP channels.",
        "Adjacency ASSUMED linear - recheck against the real connector and cable.",
        "All 12 used: path 2 (D-069) cannot return without a larger cable.",
        "FIRE_P / FIRE_N must be a twisted pair.",
        "Shield: pin 12 bonds to bench ground HERE ONLY; the station end floats."]):
    s.text(_ln, 205, 390 + _i * 4, 1.4, False)

# RECORD switch: GPIO34 is input-only and has NO internal pull-up
jr = s.place(CONN2, "J_REC", "RECORD switch", 250, 325)
s.stub(jr['1'], "RECORD")
s.power("GND", jr['2'])
rr = s.place(R, "R_REC", "10k", 290, 318, angle=90)
s.stub(rr['1'], "+3V3_LOGGER", 3); s.stub(rr['2'], "RECORD", 3)
s.text("RECORD pull-up is EXTERNAL: GPIO34 has none.\nOpen = not recording, so a broken line loses data,\nnever safety (D-032).", 306, 318, 1.4, False)

# logger-local status LED
rl = s.place(R, "R_LOG", "1k", 360, 250, angle=90)
s.stub(rl['1'], "LOGGER_LED", 3)
dl = s.place(LED, "D_LOG", "logger OK", 360, 272, angle=90)
s.lwire(rl['2'], dl['2'])
s.power("GND", dl['1'])
rv1 = s.place(R, "R_V1", "47k", 320, 365, angle=90)
s.stub(rv1['1'], "+12V_PROT", 3); s.stub(rv1['2'], "VBAT_SENSE", 3)
rv2 = s.place(R, "R_V2", "10k", 320, 392, angle=90)
s.stub(rv2['1'], "VBAT_SENSE", 3); s.power("GND", rv2['2'])
s.text("Battery sense divider: the pre-test >=12 V check\n(manual p. 12) read from the station, not by walking up.", 300, 330, 1.4, False)

s.box(12, 406, 575, 14)
s.text("TBD values await O-1 (e-match no-fire current) and O-2 (load cell datasheet).", 16, 410, 2.0, True)

s.write(OUT)
print("wrote", OUT)
print("symbols:", len(s.libs), " items:", len(s.items))
