sofi1209/TALAVERA-v1-TestBench/hardware/tools/gen_station.py

"""TALAVERA v1 - control station board schematic generator.

Two ground domains. power:GND = bench-referenced (fed from the umbilical).
power:GNDREF = laptop side (fed from USB 5 V). They must never be joined.
"""
import os
import ksch
import umbilical
from ksch import Sch

# Relative to this file, so regeneration is not tied to one machine.
OUT = os.path.join(os.path.dirname(os.path.abspath(__file__)),
                   os.pardir, "talavera-station", "talavera-station.kicad_sch")

s = Sch("talavera-station", "TALAVERA v1 - Control Station Board", paper="A1", scale=1.38,
        rev="A.2", date="2026-11-10",
        comments=("PRELIMINARY - NOT APPROVED. ARM, FIRE and E-STOP are mechanical, panel-mounted.",
                  "TWO GROUND DOMAINS: GND = bench-referenced, GNDREF = laptop/USB. Never joined.",
                  "Review owner: Emilio Guadarrama. Generated by hardware/tools/gen_station.py"))

R = "Device:R"; C = "Device:C"; D = "Device:D"; LED = "Device:LED"
CONN2 = "Connector_Generic:Conn_01x02"; CONN3 = "Connector_Generic:Conn_01x03"
CONN12 = "Connector_Generic:Conn_01x12"
ISO = "Isolator:6N137"

def hdr(t, x, y): s.text(t, x, y, 3.0)

# ================================================================ UMBILICAL
hdr("1. UMBILICAL - cable B to the bench", 15, 18)
s.box(12, 22, 175, 100)
# CORRECTED: the umbilical carries NO supply conductor. Pins 1-9 are all
# signals and 10-12 are returns, so this sheet previously claimed a power source
# that does not exist, and a PWR_FLAG on +12V_STN hid that from ERC. The station
# supply arrives on its OWN feed at J_12V, fused at F_STN. Whether to keep a
# separate feed or reallocate an umbilical conductor is decision D1 for the
# review owner - this draws the honest version of what exists today.
s.text("The station supply arrives on its OWN FEED at J_12V, fused at F_STN.", 16, 26, 1.5, False)
s.text("The 12-conductor umbilical carries NO supply conductor: 1-9 signal, 10-12 return.", 16, 30, 1.5, False)

ju = s.place(CONN12, "J_UMB", "CABLE B  12 cond.", 55, 66)
# Pin map from umbilical.py, shared with the bench (Batch 2, PROVISIONAL).
for pin, net in umbilical.PINS:
    s.stub(ju[pin], net)
# Shield bonds to ground at the BENCH end only. It was grounded at both ends,
# which contradicts the bench sheet's own "single-point to bench ground" note
# and makes the shield a second return conductor.
s.nc(ju[umbilical.SHIELD_PIN])

s.pwr_flag("+12V_FEED", 150, 22)   # the connector IS the source
s.pwr_flag("+12V_STN", 166, 34)    # downstream of F_STN: ERC needs its own driver
s.pwr_flag("+5V_USB", 172, 34)
s.pwr_flag("GND", 150, 46)
s.pwr_flag("GNDREF", 172, 46)
jp = s.place(CONN2, "J_12V", "+12V feed", 140, 55)
s.stub(jp['1'], "+12V_FEED"); s.power("GND", jp['2'])
# The station feed was UNFUSED while driving 20 m of ARM_LINE and three relay
# coils. Fuse it at the station entry.
fst = s.place("Device:Fuse", "F_STN", "TBD  O-17", 140, 40, angle=90)
s.stub(fst['1'], "+12V_FEED", 3); s.stub(fst['2'], "+12V_STN", 3)

u5b = s.place("Regulator_Linear:AMS1117-5.0", "U_5VB", "AMS1117-5.0", 115, 95)
s.stub(u5b['3'], "+12V_STN"); s.power("GND", u5b['1']); s.stub(u5b['2'], "+5V_BENCH")
u3b = s.place("Regulator_Linear:AMS1117-3.3", "U_3V3B", "AMS1117-3.3", 160, 95)
s.stub(u3b['3'], "+5V_BENCH"); s.power("GND", u3b['1']); s.stub(u3b['2'], "+3V3_BENCH")

# This board had NO capacitor on +12V_STN, +5V_BENCH or +3V3_BENCH - its only
# two were on +5V_USB and the CH340C's internal regulator, while the bench
# carries C1-C10. The AMS1117 uses output capacitance as its compensation, so
# two cascaded LDOs with none are not guaranteed stable, and an oscillating
# 3.3 V rail takes the RS-485 receiver with it.
# VALUES ASSUMED from the AMS1117 datasheet's stability note (22 uF on the
# output); confirm against the exact LCSC part before release - O-20.
for _ref, _val, _net, _x in [("C_STN1", "10uF  25V", "+12V_STN", 95),
                             ("C_STN2", "22uF  assumed", "+5V_BENCH", 137),
                             ("C_STN3", "22uF  assumed", "+3V3_BENCH", 180)]:
    _c = s.place(C, _ref, _val, _x, 112)
    s.stub(_c['1'], _net, 3); s.power("GND", _c['2'])

s.text("Bench-side rails: 5 V for the 6N137, 3.3 V for the SP3485.\n"
       "C_STN1-4 added: this board previously had NO rail decoupling at all.\n"
       "22 uF values are ASSUMED from the AMS1117 stability note - confirm (O-20).", 16, 124, 1.4, False)

# ================================================================= CONTROLS
hdr("2. CONTROLS - mechanical, panel-mounted", 15, 132)
s.box(12, 136, 175, 172)
s.text("All four are PANEL controls wired to these terminals, not PCB parts.", 16, 140, 1.5, False)

# Batch 2 (PROVISIONAL, NOT APPROVED): every panel contact below is a terminal
# for an off-board part whose make and contact rating are NOT chosen. The
# E-STOP blocks must be positive-opening (direct opening action); the key needs
# three poles; the FIRE button needs two NO poles and one NC auxiliary.
#
# J_ARMSW - removable key, three poles:
#   pole 1 changeover: PERMIT -> ARM_LINE (ON)  or  PERMIT -> TEST_FEED (OFF)
#   pole 2, closed in OFF only: FIRE_N -> GND. TEST returns through FIRE_N, and
#           when ARMED this pole is OPEN, so FIRE_N floats unless FIRE is held.
#   pole 3, closed in OFF only: part of the RESET enable chain.
ja = s.place("Connector_Generic:Conn_01x07", "J_ARMSW", "ARM key  3-pole", 45, 160)
for _p, _n in [('1', "PERMIT"), ('2', "ARM_LINE"), ('3', "TEST_FEED"),
               ('4', "FIRE_N"), ('6', "FIRE_REL"), ('7', "RESET_EN")]:
    s.stub(ja[_p], _n)
s.power("GND", ja['5'])
s.text("S_ARM key: 1-2 ON / 1-3 OFF (pole 1).\n4-5 and 6-7 CLOSED IN OFF ONLY.\nARM and TEST can never both be fed.", 62, 152, 1.3, False)

# J_FIRESW - guarded momentary. Pole A ARM_LINE -> FIRE_P, pole B FIRE_N -> GND:
# the K2/K3 coils float between FIRE_P and FIRE_N, so ONE welded pole cannot
# fire and an umbilical short of either FIRE wire to ARM or ground cannot fire.
# The NC auxiliary is in the RESET chain, so a stuck FIRE actuator blocks reset.
jf = s.place("Connector_Generic:Conn_01x06", "J_FIRESW", "FIRE  2NO+1NC", 45, 193)
for _p, _n in [('1', "ARM_LINE"), ('2', "FIRE_P"), ('3', "FIRE_N"),
               ('5', "ESTOP_OK"), ('6', "FIRE_REL")]:
    s.stub(jf[_p], _n)
s.power("GND", jf['4'])
s.text("S_FIRE guarded: 1-2 and 3-4 NO, 5-6 NC aux.\nDead unless ARMED (fed from ARM_LINE).\nSKRPABE010 NOT acceptable (D-044).", 62, 186, 1.3, False)

# J_ESTOP - latching mushroom, TWO positive-opening NC blocks, two channels:
#   block 1: ESTOP_LOOP -> GND, holds bench master K4 (channel 1, as before)
#   block 2: +12V_STN -> ESTOP_OK, feeds the ARM permit (channel 2, new)
# Channel 2 removes ARM_LINE and therefore the FIRE command, so K1, K2 and K3
# all drop and the SHUNT RE-CLOSES (M-7 / B05). Before, the E-STOP dropped K4
# only and left the shunt open while ARM was on. A short of ESTOP_LOOP to the
# shield or ground defeats channel 1 silently; channel 2 still stops a burn.
je = s.place("Connector_Generic:Conn_01x04", "J_ESTOP", "E-STOP  2x NC", 45, 222)
s.stub(je['1'], "ESTOP_LOOP"); s.power("GND", je['2'])
s.stub(je['3'], "+12V_STN"); s.stub(je['4'], "ESTOP_OK")
s.text("S_ESTOP: 1-2 drops bench K4 (ch 1).\n3-4 kills the ARM permit (ch 2):\nK1/K2/K3 drop, the shunt re-closes.", 62, 216, 1.3, False)

jt = s.place(CONN2, "J_TESTSW", "TEST  momentary", 45, 244)
s.stub(jt['1'], "TEST_FEED"); s.stub(jt['2'], "TEST_LINE")
s.text("S_TEST: momentary ONLY, never latching (H10).\nFed in key-OFF, so dead while ARMED.", 62, 241, 1.3, False)

jr = s.place(CONN2, "J_RESET", "RESET  momentary", 45, 260)
s.stub(jr['1'], "RESET_EN"); s.stub(jr['2'], "PERMIT")
s.text("S_RESET sets the permit only with E-STOP\nreleased, FIRE released and the key OFF.", 62, 257, 1.3, False)

# K5 - latched ARM permit (P-04 C). Same SRD part as the bench relays. It
# self-holds through its own NO contact from ESTOP_OK, so:
#   - releasing a latched E-STOP does NOT re-arm the bench, even with the key
#     left ON - a deliberate RESET is required (no automatic restart);
#   - station power-up also comes up with the permit OFF;
#   - a welded K5 loses only this anti-restart property: its COM is fed from
#     E-STOP block 2, so channel 2 still removes ARM.
k5 = s.place("Relay:Relay_SPDT", "K5", "SRD-12VDC-SL-C", 140, 285)
s.stub(k5['A1'], "PERMIT"); s.power("GND", k5['A2'])
s.stub(k5['11'], "ESTOP_OK"); s.stub(k5['14'], "PERMIT")
s.nc(k5['12'])
dk5 = s.place(D, "D_K5", "1N4148W", 172, 283, angle=90)
s.stub(dk5['1'], "PERMIT", 6); s.power("GND", dk5['2'], 6)          # K to +ve
s.text("K5 ARM PERMIT: latches via its own NO.\nE-STOP release does NOT re-arm.", 16, 278, 1.3, False)

# ======================================================= INDICATORS & AUDIO
hdr("3. INDICATORS & AUDIO", 15, 318)
s.box(12, 322, 175, 92)
for i, (ref, anode_net, cath_net, lbl) in enumerate([
        ("D_ARMED", "ARM_LINE", None, "ARMED"),
        ("D_CONT", "PYRO_CONT_SENSE", None, "CONTINUITY OK"),
        ("D_PWR", "+12V_STN", None, "POWER")]):
    rr = s.place(R, "R_" + ref, "1k", 35 + i * 42, 326, angle=90)
    s.stub(rr['1'], anode_net, 3)
    dd = s.place(LED, ref, lbl, 35 + i * 42, 348, angle=90)
    s.lwire(rr['2'], dd['2'])
    if cath_net: s.stub(dd['1'], cath_net, 10.16)
    else:        s.power("GND", dd['1'])
s.text("ARMED lamp driven from the REAL arm line (D-017).", 16, 360, 1.4, False)

# The continuity sense is now ACTIVE-HIGH (P-01, Batch 2): the bench opto
# SOURCES current into PYRO_CONT_SENSE from K1's NC contact, and D_CONT returns
# it to ground here. R_CONT_PU is deleted. With the old active-low sense, a short
# of the sense conductor to ground, to the shield, or to ESTOP_LOOP lit the lamp
# with no match fitted. Now those shorts read "no continuity", and the lamp
# cannot light while ARMED because its source is dead then.
for _i, _ln in enumerate([
        "CONTINUITY lamp is ACTIVE-HIGH: the bench sources it, only",
        "during TEST and only while DISARMED. LIT = current through the",
        "match. A sense-line short to ground reads 'no match' (safe)."]):
    s.text(_ln, 16, 366 + _i * 4, 1.4, False)

bz = s.place("Device:Buzzer", "LS1", "MLT-8530", 55, 385)
s.stub(bz['1'], "+12V_STN"); s.stub(bz['2'], "BUZZ_DRV")
q1 = s.place("Device:Q_NMOS", "Q_BUZZ", "NTS4001NT1G", 100, 388)
s.stub(q1['G'], "BUZZ_GATE")       # C-5: divided, not raw 12 V
rbg1 = s.place(R, "R_BG1", "10k", 100, 362, angle=90)
s.stub(rbg1['1'], "ARM_LINE", 3); s.stub(rbg1['2'], "BUZZ_GATE", 3)
rbg2 = s.place(R, "R_BG2", "6k8", 128, 362, angle=90)
s.stub(rbg2['1'], "BUZZ_GATE", 3); s.power("GND", rbg2['2'])
s.stub(q1['D'], "BUZZ_DRV")
s.power("GND", q1['S'])
db = s.place(D, "D_BUZZ", "1N4148W", 135, 383, angle=90)
s.stub(db['1'], "+12V_STN", 6); s.stub(db['2'], "BUZZ_DRV", 6)   # C-4: K to +ve
s.text("Audible ARMED warning - the manual relies on visual cues only.", 16, 400, 1.4, False)

# ========================================== TELEMETRY + ISOLATION BARRIER
hdr("4. TELEMETRY - RS-485 in, isolated, out to USB", 200, 18)
s.box(197, 22, 195, 240)
s.text("ISOLATION BARRIER down the middle of this block.", 201, 26, 1.7, True)
s.text("LEFT = bench-referenced (GND).  RIGHT = laptop side (GNDREF).", 201, 31, 1.5, False)
s.text("No isolated DC-DC: the laptop's USB supplies the isolated side (D-056).", 201, 35, 1.5, False)

u485 = s.place("Interface_UART:SP3485EN", "U_485", "SP3485EN-L/TR", 240, 80)
s.stub(u485['6'], "RS485_A"); s.stub(u485['7'], "RS485_B")
s.stub(u485['1'], "RO_BENCH"); s.stub(u485['4'], "DI_BENCH")
s.stub(u485['2'], "RS485_RE"); s.stub(u485['3'], "RS485_DE")
s.power("GND", u485['5'])
s.stub(u485['8'], "+3V3_BENCH")
# U_485 had no local bypass at all while switching an RS-485 line.
# LAYOUT: place at the VCC pin, not near the regulator.
c485 = s.place(C, "C_485", "100nF", 215, 68)
s.stub(c485['1'], "+3V3_BENCH", 3); s.power("GND", c485['2'])
rt = s.place(R, "R_TERM", "120R", 207, 92, angle=90)
s.stub(rt['1'], "RS485_A", 3); s.stub(rt['2'], "RS485_B", 3)
# receive-only station: RE low, DE low
rre = s.place(R, "R_RE", "0R", 285, 55, angle=90)
s.stub(rre['1'], "RS485_RE", 3); s.power("GND", rre['2'])
rde = s.place(R, "R_DE", "0R", 310, 55, angle=90)
s.stub(rde['1'], "RS485_DE", 3); s.power("GND", rde['2'])
s.text("Station is receive-only by default: RE and DE\nboth pulled low. Fitting the TX path is optional\nand still carries no command authority.", 263, 60, 1.3, False)

# ---- RX across the barrier: bench RO -> opto LED -> laptop UART RX
ri1 = s.place(R, "R_ISO1", "220R", 250, 140, angle=90)
s.stub(ri1['1'], "RO_BENCH", 3); s.stub(ri1['2'], "ISO1_A", 3)
i1 = s.place(ISO, "U_ISO1", "6N137  RX", 310, 150)
s.stub(i1['2'], "ISO1_A")
s.power("GND", i1['3'])
s.stub(i1['8'], "+5V_USB"); s.stub(i1['7'], "+5V_USB")
s.power("GNDREF", i1['5'])
s.stub(i1['6'], "UART_RX_USB")
rp1 = s.place(R, "R_ISO1_PU", "4k7", 365, 140, angle=90)
s.stub(rp1['1'], "+5V_USB", 3); s.stub(rp1['2'], "UART_RX_USB", 3)
# The 6N137 datasheet requires a 0.1 uF bypass between pins 8 and 5. Neither
# isolator had one; C_USB is shared with the CH340C and is not a local bypass.
# LAYOUT: directly at pins 8-5 of each device.
ci1 = s.place(C, "C_ISO1", "100nF", 340, 128)
s.stub(ci1['1'], "+5V_USB", 3); s.power("GNDREF", ci1['2'])

# ---- TX across the barrier: laptop TX -> opto LED -> bench DI
ri2 = s.place(R, "R_ISO2", "220R  DNP", 250, 215, angle=90, dnp=True)
s.stub(ri2['1'], "UART_TX_USB", 3); s.stub(ri2['2'], "ISO2_A", 3)
i2 = s.place(ISO, "U_ISO2", "6N137  TX  DNP", 310, 225, dnp=True)
s.stub(i2['2'], "ISO2_A")
s.power("GNDREF", i2['3'])
s.stub(i2['8'], "+5V_BENCH"); s.stub(i2['7'], "+5V_BENCH")
s.power("GND", i2['5'])
s.stub(i2['6'], "DI_BENCH")
rp2 = s.place(R, "R_ISO2_PU", "4k7  DNP", 365, 215, angle=90, dnp=True)
s.stub(rp2['1'], "+5V_BENCH", 3); s.stub(rp2['2'], "DI_BENCH", 3)
ci2 = s.place(C, "C_ISO2", "100nF  DNP", 340, 203, dnp=True)
s.stub(ci2['1'], "+5V_BENCH", 3); s.power("GND", ci2['2'])
s.text("6N137 is fast enough for 115200 baud. The TLP521 / PC817\n"
       "already in stock are NOT - do not substitute (O-6).", 205, 258, 1.4, False)
s.text("O-21 OPEN, NOT FIXED HERE: this RX path INVERTS.\n"
       "LED conducts on RO HIGH and an enabled 6N137 pulls its\n"
       "output LOW, so an idle mark reaches the CH340C as a\n"
       "continuous break. Telemetry cannot work as drawn. The fix\n"
       "is a part change, not a rewire - see REV-A1-CHANGES.", 205, 242, 1.4, False)

# ================================================================== USB-C
hdr("5. USB-C - laptop side, GNDREF domain", 405, 18)
s.box(402, 22, 180, 240)

u340 = s.place("Interface_USB:CH340C", "U_USB", "CH340C", 480, 75)
s.stub(u340['2'], "UART_TX_USB"); s.stub(u340['3'], "UART_RX_USB")
s.stub(u340['5'], "USB_DP", 5.08); s.stub(u340['6'], "USB_DM", 21.59)
s.stub(u340['16'], "+5V_USB", 12.7)
s.power("GNDREF", u340['1'])
s.stub(u340['4'], "USB_V3")
s.nc(*[u340[pn] for pn in ['7','8','9','10','11','12','13','14','15']])
s.nc(i1['1'], i1['4'], i2['1'], i2['4'])
c4 = s.place(C, "C_V3", "100nF", 540, 60)
s.stub(c4['1'], "USB_V3", 3); s.power("GNDREF", c4['2'])
c8 = s.place(C, "C_USB", "100nF", 560, 60)
s.stub(c8['1'], "+5V_USB", 3); s.power("GNDREF", c8['2'])

jub = s.place("Connector:USB_C_Receptacle_USB2.0_14P", "J_USB", "TYPE-C-31-M-12", 450, 185)
for p in ['A1', 'B1', 'A12', 'B12']:
    s.power("GNDREF", jub[p])
for p in ['A4', 'B4', 'A9', 'B9']:
    s.stub(jub[p], "+5V_USB")
s.stub(jub['A5'], "CC1"); s.stub(jub['B5'], "CC2")
s.stub(jub['A6'], "USB_DP_C"); s.stub(jub['B6'], "USB_DP_C")
s.stub(jub['A7'], "USB_DM_C"); s.stub(jub['B7'], "USB_DM_C")
s.power("GNDREF", jub['SH'])

for i, (ref, net) in enumerate([("R_CC1", "CC1"), ("R_CC2", "CC2")]):
    rc = s.place(R, ref, "5k1", 545 + i * 20, 150, angle=90)
    s.stub(rc['1'], net, 3); s.power("GNDREF", rc['2'])
for i, (ref, a, b) in enumerate([("R_DP", "USB_DP", "USB_DP_C"), ("R_DM", "USB_DM", "USB_DM_C")]):
    rd = s.place(R, ref, "22R", 420 + i * 22, 125 + i * 11.43, angle=90)
    s.stub(rd['1'], a, 3); s.stub(rd['2'], b, 3)
for i, (ref, net) in enumerate([("D_ESD1", "USB_DP_C"), ("D_ESD2", "USB_DM_C")]):
    de = s.place("Device:D_TVS", ref, "ESD9B5.0ST5G", 420 + i * 22, 230, angle=90)
    s.power("GNDREF", de['1']); s.stub(de['2'], net, 3)
s.text("CC pull-downs 5k1 mark this as a UFP sink.\nData series 22R, one ESD diode per line.", 406, 250, 1.4, False)

# ======================================================= MEASUREMENT OUTPUT
hdr("6. MEASUREMENT OUTPUT - works with no software at all", 200, 274)
s.box(197, 278, 215, 110)
s.text("PATH 2 IS DEFERRED FOR REV A. The SD log is the measurement.", 201, 282, 1.5, False)

jd = s.place(CONN3, "J_DAQ", "DAQ out  NOT FITTED", 250, 320, dnp=True)
s.nc(jd['1'], jd['2'], jd['3'])
s.text("J_DAQ IS NOT FITTED IN REV A (O-19).\n"
       "It was wired to umbilical pins 8/9, which reach NOTHING on the\n"
       "bench: no buffer, no source. A connector present at both ends of\n"
       "a dead pair reads as a working analog backup, so it is unpopulated\n"
       "and its pins are flagged rather than left inviting a DAQ.\n"
       "Pin 3 also exported bench GND to the laptop bench, which bridges\n"
       "the isolation barrier whenever a mains-powered DAQ shares it.\n"
       "Loss of path-2 redundancy for Rev A is recorded in REQUIREMENTS.md.", 282, 310, 1.4, False)

jv = s.place(CONN2, "J_VM", "voltmeter module", 250, 365)
s.stub(jv['1'], "VBAT_SENSE"); s.power("GND", jv['2'])
s.text("Battery voltmeter: the pre-test >= 12 V check (manual p. 12),\nread without walking to the bench.", 282, 362, 1.4, False)



s.box(12, 406, 575, 14)
s.text("TBD values await O-2 (load cell) and O-6 (isolator part). ARM / FIRE / E-STOP carry no firmware.",
       16, 410, 2.0, True)

s.write(OUT)
print("wrote", OUT)
print("symbols:", len(s.libs), " items:", len(s.items))
