sofi1209/TALAVERA-v1-TestBench/(commit log)

2026-11-06 Gate 0: requirements, safety docs, and KiCad 10 project skeletons
    Initial scaffolding for TALAVERA, the replacement electronics for the Wirikuta 1.1 static test bench. No microcontroller on the arm, fire or e-stop path: those are switches, relay contacts and resistors.
    Schematics are intentionally empty. Gate 2 is not approved and no circuit has been designed. Each sheet carries the non-negotiable design rules as a text block so they live in the tool, not only in a document.
    Net classes PYRO, SAFETY, POWER and ANALOG are pre-defined with pattern assignment so DRC itself enforces pyro clearance and trace width.
    Includes the preliminary operations manual, hazard analysis with named safe sta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
    [talavera-bench.kicad_pcb, talavera-bench.kicad_sch, talavera-station.kicad_pcb, talavera-station.kicad_sch]
2026-11-06 Logger: switch to ESP32-DevKitC V4 (ESP32-WROOM-32D)
    Replaces the Arduino UNO in the logger. The logger remains a zero-authority passenger: no outputs, no connection to any safety net, own fused rail, layout keep-out. The safety argument is unchanged.
    3.3 V is native for microSD and I2C, so the level shifting a 5 V Arduino needed disappears. The AD620 gain must now keep its output inside the ADS1115 input range at 3.3 V, tracked as open item 11.
    Wi-Fi and Bluetooth are stopped as the first action at boot and must never be enabled. A +20 dBm 2.4 GHz transmitter centimetres from the AD620 front end and a 20 m pyrotechnic cable is an EMI source next to the two most sensitive things on the ben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
    [logger.ino]
2026-11-06 Reopen ADC selection, adopt on-board microSD, reject direct-USB umbilical
    ADC: D-030 reopened as D-036. The ADS1115 is no longer assumed. While reviewing IGNIS-v5 for its storage circuit, its DataLogger.h turned out to document the same I2C solder-joint trouble and to deliberately keep the data path on SPI - a second board in the same lab reaching the same conclusion. So the primary criterion is moving off I2C, not improving conversion quality. Trade study in docs/ADC-TRADE-STUDY.md assesses seven candidates; recommendation is AD7190 (SPI, integrated bridge PGA, deletes the AD620 stage as well) with ADS1256 as second source. All figures flagged unverified pending datasheet confirmation. The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
    [logger.ino]
2026-11-06 Add preliminary parts list in IGNIS/MAGNIS format; resolve two open items
    Parts list for both boards in fabrication/, matching the IGNIS_V5_Parts_List_rev3 and MAGNIS_v1_Parts_List column format, as Markdown plus two CSVs. 35 lines confirmed against existing lab stock, 24 still TBD or pending a decision. Labelled explicitly as not a BOM: there is no netlist to reconcile designators and quantities against, unlike the IGNIS and MAGNIS lists.
    Resolved: microSD socket is THD2528-11SD-GF (C283232), found in both lists, closing open item 14. Logger mounting resolved as socketed DevKitC on PPTC191LFBN-RC sockets plus a hold-down, following the MAGNIS v1 precedent, closing open item 10.
    Two findin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
    [TALAVERA_v1_Parts_List_bench.csv, TALAVERA_v1_Parts_List_station.csv]
2026-11-06 Select ADS1220 as the converter; close the logger power, telemetry and fab decisions
    ADC: ADS1220IPWR (D-046). Sofia chose the minimum-change logic but required availability at UNIT or LCSC, preferably both. The ADS1220 is stocked at both - UNIT lists ADS1220IPWR, LCSC C48263 holds ~15.9k at roughly 1.71 USD at 100 - and it is TI's own bridge-sensor part: 24-bit, SPI, 2 kSPS, integrated PGA x1-128, TSSOP-16, 2.3-5.5 V so it runs natively at 3.3 V. It replaces the ADS1115 and removes the I2C bus that both Wirikuta and IGNIS-v5 had trouble with.
    The AD620 is NOT populated. The SOIC AD620ARZ is listed under LCSC 'Pre-ordered Products', so JLCPCB very likely cannot place it, which makes a popul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
    [TALAVERA_v1_Parts_List_bench.csv, TALAVERA_v1_Parts_List_station.csv]
2026-11-06 Name Emilio Guadarrama as design review owner
    Closes open item 1, the last governance blocker before Gate 2. He co-drew Pyros.SchDoc in IGNIS v4/2v2, so he is well placed to review the pyro section - including whether declining its MCU gate-drive half (D-045) is the right call.
    Filled in across README, SAFETY.md (header and the Gate 1-6 sign-off table), DECISION-LOG.md, REQUIREMENTS.md and the operations manual document control block. Stage 5 of the bring-up plan still requires a separate written authorisation from him naming the safe setup, location, personnel and standoff.
    Also corrected three stale entries found while editing: the logger power domain was still listed as open in REQUIREM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
2026-11-06 docs: rebuild the open-items list, which had gone self-contradictory
    Closing items in place by striking them through left the list inconsistent: item 10 appeared twice, once open and once closed, and items 8, 12 and 15 were still listed as open after D-046, D-048 and D-049 had settled them.
    Rebuilt as three sections - two items blocking Gate 2, twelve needed during Gates 2 and 3, and a closed table with the deciding decision for each. Renumbered O-1 to O-14 so the numbering no longer has gaps and duplicates.
    Two items added that had not been tracked: board size target per board, and copper weight, which the PYRO net class 2.00 mm track width silently assumes to be 1 oz.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
2026-11-06 Hand assembly and a cheap-sourcing policy reshape the part choices
    Rev A is a bare PCB, hand-assembled (D-051), which relaxes the LCSC-placeable constraint to merely buyable from LCSC or UNIT. Component selection policy formalised (D-052): cheap, reliably sourced, hand-solderable, with one part number serving several positions where possible. Safety-critical ratings are explicitly exempt from the price rule.
    Design-gate policy relaxed for Gates 2-5 only (D-053). Proceeding without per-gate sign-off is not prejudicial while no hardware exists - an error in a drawing costs time, not safety. Gate 6, which releases files to a fab, and Stage 5 of bring-up, which connects a live initiator, keep m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
    [TALAVERA_v1_Parts_List_bench.csv, TALAVERA_v1_Parts_List_station.csv]
2026-11-06 Add Gate 2 readiness plan: nothing blocks starting the schematic
    Checked the installed KiCad 10 libraries rather than assuming. Every symbol needed is already in stock libraries - ADS1220 in Analog_ADC, AD620 in Amplifier_Instrumentation, SP3485 in Interface_UART, CH340 in Interface_USB, ESP32-WROOM-32D in RF_Module, microSD and USB-C in Connector, and a generic SPDT relay that fits the SRD-12VDC-SL-C. Nothing needs drawing as a symbol.
    Three footprints need creating or importing: the Songle SRD relay (Relay_THT has Schrack, Axicom, Finder and Fujitsu but no Songle), the THD2528 microSD socket (Connector_Card has Hirose and Molex only), and the HRO TYPE-C-31-M-12. All three already exist in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
2026-11-06 docs: correct two stale rows in the requirements
    The settled-parameters table still said JLCPCB-assembled with an LCSC-stocked constraint, superseded by D-051 and D-052, and the status line still said Gate 1 awaiting approval, superseded by D-053. Added the relay, RS-485 and selection-policy rows that were decided but never recorded there.
2026-11-06 Gate 2: draw both schematics
    Both boards drawn: bench 54 components / 47 nets, station 42 components / 31 nets, zero structural errors. Flat single A2 sheets with net-label connectivity and boxed, titled functional blocks - at this size easier to review than nine hierarchical sub-sheets.
    Generated rather than hand-drawn, from hardware/tools/. ksch.py reads symbol definitions out of the installed KiCad 10 libraries and flattens extends inheritance, so ADS1220, SP3485EN and AMS1117 resolve correctly. validate_sch.py checks structure independently of KiCad: paren balance, lib_id resolution, instance pins existing in their symbols, duplicate references, off-sheet placement, orphaned labels and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
    [talavera-bench.kicad_sch, talavera-station.kicad_sch]
2026-11-06 docs: refresh three stale sections in hardware/README
    The microSD socket was still listed as TBD though D-041 resolved it to THD2528-11SD-GF, the ADC section still said selection reopened though D-046 settled on the ADS1220, and the 5 V rail was marked as possibly unnecessary - it is needed after all, because the AD620 cannot run below 4.6 V total supply (D-061).
2026-11-06 Fix root-sheet UUID mismatch and emit canonical s-expression formatting
    The .kicad_pro sheets entry still held the UUID from the original empty skeleton, while the regenerated .kicad_sch had a new root UUID. KiCad would not have matched the sheet to its project entry. Both project files now carry the live schematic UUID.
    The serializer also put each leading atom on its own line, so symbol definitions read as (symbol followed by a newline and then the name. That parses, but it is not how KiCad writes files and it made the output hard to inspect - it is why a grep for lib_symbols content returned zero and briefly looked like the definitions were missing. Leading atoms now stay on the head lin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
    [talavera-bench.kicad_sch, talavera-station.kicad_sch]
2026-11-06 Fix unterminated-string error that stopped KiCad loading the schematics
    KiCad 10.0.5 refused both files with 'Unterminated delimited string ... line 6399, offset 59'. Cause: multi-line text annotations wrote literal line breaks inside quoted strings. KiCad requires a \n escape there; a raw newline terminates nothing and the parser runs off the end of the string.
    ksch.py now round-trips strings properly: unesc() on parse so library content is decoded once, esc() on serialise so backslash, quote, newline, tab and CR are encoded on the way out. Applied to every path that emits a string, including the hand-built templates for symbols, labels, text, titles and title-block comments.
    validate_sch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
    [talavera-bench.kicad_sch, talavera-station.kicad_sch]
2026-11-06 Draw the microcontroller as an ESP32, and fix the firmware still being written for I2C
    The logger was drawn as two generic 19-pin connectors, which is physically accurate for a socketed DevKitC but reads as two anonymous headers rather than a microcontroller - Sofia could not find it on the sheet. MCU1 is now the RF_Module:ESP32-WROOM-32D symbol with real GPIO names, annotated that the physical part is a socketed DevKitC V4 whose symbol-to-socket mapping is set when that footprint is made (O-16). Adds the EN pull-up and cap and the 3V3 decoupling that the connector representation had no place for.
    Redrawing it exposed that the firmware was still written for the ADS1115 on I2C, three decisio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
    [talavera-bench.kicad_sch]
2026-11-06 docs: finish the ADS1115 to ADS1220 migration in firmware/README
    The Target table, the internal-ADC section and the logger constraints still described the ADS1115 on I2C at 860 SPS behind an AD620, and still listed the DevKitC mounting as an open item after D-042 closed it.
2026-11-06 Fix the rotation bug behind all 200 ERC errors
    ERC on the station board returned 200 errors - dangling wires, dangling labels and unconnected pins across nearly every rotated part. Root cause: place() accepted an angle argument, passed it into the symbol instance so KiCad drew the part rotated, but computed the returned pin coordinates as if the angle were zero. Every wire was then drawn to where the pin would have been unrotated. 35 symbols across the two boards were placed at 90 degrees.
    Verified against the ERC report rather than by eye: ERC placed R_D_ARMED pin 1 at (31.19, 326.0); the corrected transform now returns exactly that. Rotation happens in symbol space, counter-clockwise, bef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
    [talavera-bench.kicad_sch, talavera-station.kicad_sch]
2026-11-07 Fix all four regulators wired backwards, and snap the schematic to grid
    ERC run 2 came back with 0 errors - the connectivity fixes held - but 206 warnings, and two of them were not cosmetic: ground_pin_not_ground on U_5VB and U_3V3B.
    The AMS1117 pinout is 1=GND, 2=VO, 3=VI. I had wired all four regulators as if it were 1=VI, 2=GND, 3=VO, so every one had the 12 V rail on its ground pin, its output shorted to ground, and the input pin driving the output rail. On a real board that destroys the part and the 3.3 V rail never exists. Corrected on both boards.
    The other 204 warnings were endpoint_off_grid: KiCad's schematic connection grid is 50 mil (1.27 mm) and I had been placing symbols at ar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
    [talavera-bench.kicad_sch, talavera-station.kicad_sch]
2026-11-09 Pre-fabrication audit: 5 critical findings, board not fit to build
    Re-audited both schematics by extracting and resolving the netlist independently of KiCad, then reading every net. KiCad ERC passed this revision with 0 errors and the project validator reported 0 errors; neither checks whether a circuit is correct, only whether it is connected. Every finding is a connected, legal, wrong circuit.
    C-1: the 3.3 V rail exists as two unconnected nets. The regulator output is on +3V3_LOGGER and drives only capacitors, while the ESP32, ADS1220, microSD and SP3485 all sit on +3V3. No integrated circuit on the bench board has a supply. Same mistake as the earlier GND_RTN split, which I fixed on grou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
    [netlist.py]
2026-11-09 docs: README status banner still claimed the schematics were empty skeletons
2026-11-09 Apply the audit fixes: 10 of 12 findings closed
    C-1: the 3.3 V rail is one net again - the regulator and all five IC supply pins sit on +3V3_LOGGER. C-2: the load cell gets excitation through R_EXC_P and R_EXC_N 0 ohm links, so a precision source can replace them later without cutting a track. C-3 and C-4: all five flyback diodes now have their cathode on the coil's positive side. C-5: a 10k/6k8 divider puts 4.86 V on the buzzer gate instead of 12 V, though the datasheet Vgs check still stands.
    H-1: the continuity lamp now hangs off +12 V and sinks into the sense node, so lamp lit means good match - it read exactly inverted before. H-2: the test button is removed outright, since it shorted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
    [talavera-bench.kicad_sch, talavera-station.kicad_sch]
2026-11-09 Add session handoff and project skills scaffolding
    docs/HANDOFF.md carries the state a new session needs: where each gate stands, the two data items that block real progress, the three open design decisions, and the component choices already settled with their reasons.
    Its most valuable section is the table of bugs that cost real time in this session - raw newlines that stopped KiCad loading the file, place() ignoring rotation and producing 200 ERC errors, labels offset half a millimetre from the wire end, two separate net-name splits that left circuits unpowered, all four AMS1117 wired as if pin 1 were VI when it is GND, five reversed flyback diodes, and a patch comment that swallowed a st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
2026-11-09 exports: KiCad ERC reports and schematic PDFs for the audited revision
    The repository had no ERC evidence for the bench board. The only reports in version control were hardware/talavera-station/ERC.rpt and ERC-run2.rpt, both station-only and both warnings-only runs. Nothing recorded what KiCad's own ERC made of talavera-bench, which is why the 6 November audit's "0 errors" claim rested on validate_sch.py - a different and narrower check - rather than on ERC.
    Running kicad-cli 10.0.5 against the committed revision gives 1 error and 2 warnings on the bench and 0 on the station. The error is a power_pin_not_driven on U_3V3 pin 3, because only +12V_RAW and GND carry PWR_FLAG and ERC does not pr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
2026-11-09 Follow-up audit: the reverse-polarity diode is backwards, so the bench never powers up
    D_RP is a series SS24 whose job the generator annotates as "reverse-polarity block". Its cathode is on +12V_FUSED, the incoming side, and its anode on +12V_PROT, the load side. KiCad's own netlist export confirms the pin functions: pin 1 is K_1 on the fused input, pin 2 is A_2 on the protected rail. In normal polarity that diode is reverse-biased, so nothing downstream of the fuse is powered - not the logger rail, not the master relay, not the safety chain, not either regulator. The fix is to swap the two stubs in gen_bench.py lines 35-36.
    This is the sixth reversed diode in this project. Five flyback dio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
2026-11-10 Reconcile two independent audits: the bench cannot fire, and my N-3 was wrong
    Both reviewers, working from the cross-model handoff and independently of each other, found that the firing loop has no return. PYRO_MATCH_N has exactly three pins - K3.12, P1.2 and U_CONT1.2 - and all of them lead back to PYRO_MATCH_P. U_CONT1.3 is on ground but that is the phototransistor emitter, across the isolation barrier. No current can flow in any state, so the bench cannot fire. Root cause: D-045 dropped the IGNIS gate drive, where the low-side MOSFET was the return, and D-059/O-18 then deleted cable A, which had carried the station-sourced sense current. Both halves were removed for defensible reasons and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
2026-11-10 R-2: the validator could report "0 errors" while checking nothing
    validate_sch.py resolved every symbol through a SYMDIR hardcoded to one machine, inside except Exception: continue. With that path wrong it returned a byte-identical "0 errors" - same stats, same warning, same exit code - while the pin-coincidence, floating-pin and power-pin-semantic checks silently did nothing. Those three are the guards added after the GND_RTN split, the AMS1117 pin-1 error and the SP3485 left with no ground, so the project's defences against its own worst bugs were one KiCad point upgrade away from vanishing with no signal at all. Reproduced both ways before and after.
    SYMDIR now resolves from $TALAVERA_SY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
    [ksch.py, sync_project_uuid.py, trace_fire_loop.py, validate_sch.py]
2026-11-10 Give the firing loop a return, so the bench can actually fire
    PYRO_MATCH_N reached exactly three pins - K3.12, P1.2 and U_CONT1.2 - and all three led back to PYRO_MATCH_P. U_CONT1.3 sits on ground but that is the phototransistor emitter, across the isolation barrier. No path to the supply return existed, so no current could flow in any state and the bench could not fire. Cause: D-045 dropped the IGNIS gate drive, where the low-side MOSFET was the return, and D-059/O-18 then deleted cable A, which had carried the station-sourced sense current. Both halves went for defensible reasons and nothing replaced either.
    K3 now carries both jobs on one Form C pole, using the contact that was already u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
    [talavera-bench.kicad_sch, talavera-station.kicad_sch]
2026-11-10 docs and parts list: record Rev A.1, and retire the claims that were wrong
    REV-A1-CHANGES-2026-11-09.md is the change record: what was fixed, what was verified and how, and a table of nine items deliberately left alone with what each one needs. It states plainly that the K3 topology is provisional on decision D-A and the Songle break-before-make evidence, and that nothing is approved.
    HANDOFF.md section 4.3 claimed sense current crosses the e-match continuously. That is withdrawn, with the correction in place rather than a quiet rewrite: nothing sources that current, and the real defect was the opposite and worse. Its regeneration routine now has four steps instead of two, because the two i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
    [TALAVERA_v1_Parts_List_bench.csv, TALAVERA_v1_Parts_List_station.csv]
2026-11-10 SAFETY and OPERATIONS-MANUAL: the manual told the operator to trust a check that cannot work
    This is the most dangerous artifact in the repository as it stood, and it is not a schematic. Step 5 of the pre-arm procedure instructed the operator to press CONTINUITY and confirm the lamp indicated a connected match, then to not arm if it did not indicate. There is no such button - it was removed on 6 November for forcing a false good - and the audits of 9 November established there is no working check at all, because R_CONT and the optocoupler sit in parallel with the match with nothing driving them before arming. The lamp cannot light in any state.
    The lamp therefore reads "no match" permanentl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
2026-11-10 Make both sheets readable, and record the external abort interrupt
    The schematics had text on text, net labels landing on reference and value text, and notes running outside their section boxes - including two collisions I introduced myself last commit by dropping R_STAR straight onto the D-047 note. check_layout.py is new and measures what ERC and the validator do not: whether a human can read the sheet. It reports text/text, text/symbol, symbol/symbol, label and property collisions, and anything that escapes the dashed box it belongs to, and exits non-zero. Bench went from 17 reported collisions to zero, station from 12 to zero.
    R_STAR moves clear of the logger-rail note, the D_RP annotat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
    [talavera-bench.kicad_sch, talavera-station.kicad_sch]
2026-11-10 Rework both sheets onto A1 and fix the drawing engine that made them unreadable
    The sheets were not just crowded, they were being drawn wrong, and three bugs in ksch.py account for most of what was on screen.
    KiCad never draws text upside down: it renders a 180 degree label as 0 degrees and a 270 degree label as 90, swapping the justification to match. stub() kept "left" for all four, so every label on a leftward or downward pin ran BACK INTO the symbol it belonged to. That is why +12V_LOGGER printed across the AMS1117 body.
    A property's angle is RELATIVE to its symbol, not absolute. Writing a literal 0 therefore printed the designator and value sideways on every rotated part, which is how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
    [talavera-bench.kicad_sch, talavera-station.kicad_sch]
2026-11-10 Gate 4 readiness: layout must not start, with the floorplan ready for when it can
    check_layout_ready.py answers the question mechanically rather than by opinion, and separates three kinds of gate because they fail for different reasons. BLOCKING is what stops you placing and routing at all. TOPOLOGY is an open decision that changes which parts exist on the board. SIZING is copper that cannot be computed without data nobody has yet.
    The verdict is 2 blocking, 8 topology, 6 sizing. The schematic itself is in good shape - validator 0/0, native ERC 0 violations on both boards, the firing-loop tracer passing all five states, UUIDs in sync - but 110 of 110 components have no footprint and both .k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
    [check_layout_ready.py]
2026-11-10 Clear the ERC warnings on KiCad 10.0.8 and bring the Rev A.1 labelling and docs up to date
    Native ERC was only clean on 10.0.5. On 10.0.8 it reported 7 warnings: four lib_symbol_mismatch on Relay_SPDT and three same_local_global_label on GND and GNDREF. The relay pin numbers, positions and types were identical to the library, so that was symbol drift, and regenerating re-embeds the current symbol. The label warnings came from ground stubs and PWR_FLAGs attaching a local GND label next to a power symbol of the same name, so ksch.stub() and pwr_flag() now draw ground as a power symbol. Every net of both boards compares identical to the previous netlist, so connectivity is unchanged.
    The title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
    [talavera-bench.kicad_sch, talavera-station.kicad_sch]
2026-11-10 Batch 2 safety topology: K3 on FIRE, floating FIRE loop, continuity TEST, two-channel E-STOP, crowbar
    Six safety-topology problems were analysed with options and the recommended set is drawn as Rev A.2. Under Rev A.1 a single welded K2 fired the bench on ARM, because ARM closed K1 and K3 together, and an ARM/FIRE short on adjacent umbilical pins 1/2 did the same. K3 keeps both contacts of its Form C pole but its coil now follows the FIRE command, so a K2 or K3 weld alone cannot fire and the shunt stays closed and isolated through the whole armed wait. FIRE becomes a floating two-wire loop with a double-pole button, so a short of either FIRE wire to ARM or ground cannot energise the coils. Th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
    [TALAVERA_v1_Parts_List_bench.csv, TALAVERA_v1_Parts_List_station.csv, netlist-diff-vs-main-bench.txt, netlist-diff-vs-main-station.txt, talavera-bench.kicad_sch, talavera-station.kicad_sch]
